OpenSourceEBike/EV_Display_Bluetooth_Ant/README.md

This project files were moved to: https://github.com/OpenSourceEBike/EBike_EScooter_modular_DIY
