OpenSourceEBike/EV_Display_Bluetooth_Ant/hardware/VESC/schematic-OLED_SPI-VESC.png

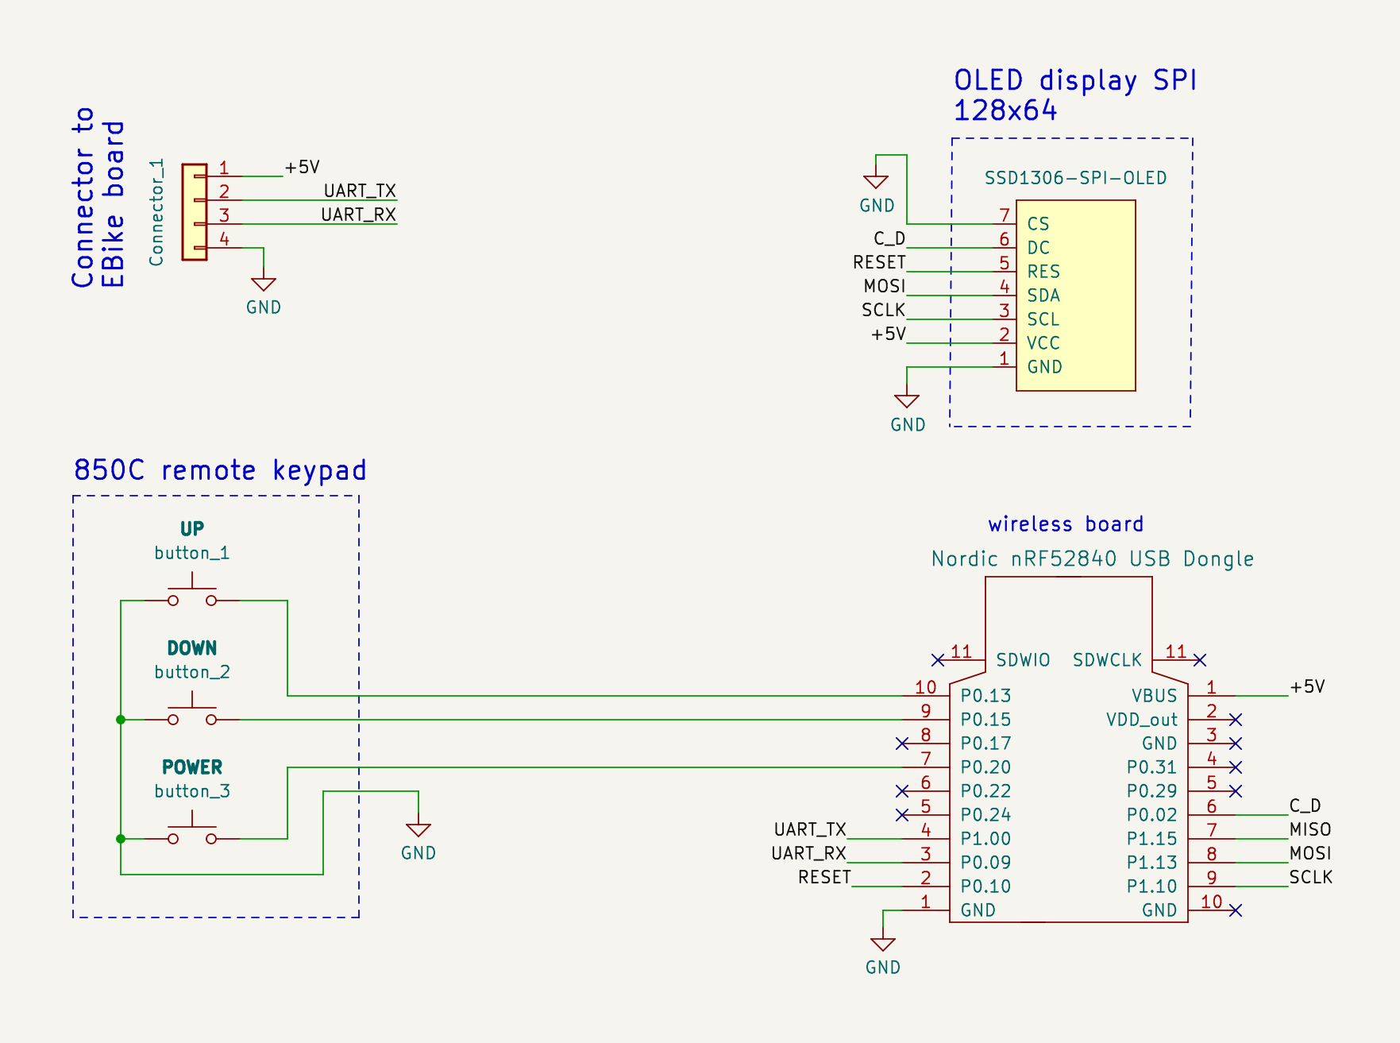
hardware/VESC/schematic-OLED_SPI-VESC.png
