OpenSourceEBike/EV_Display_Bluetooth_Ant/3D_print_enclosure/Bafang_M500_M600/assembly.FCStd

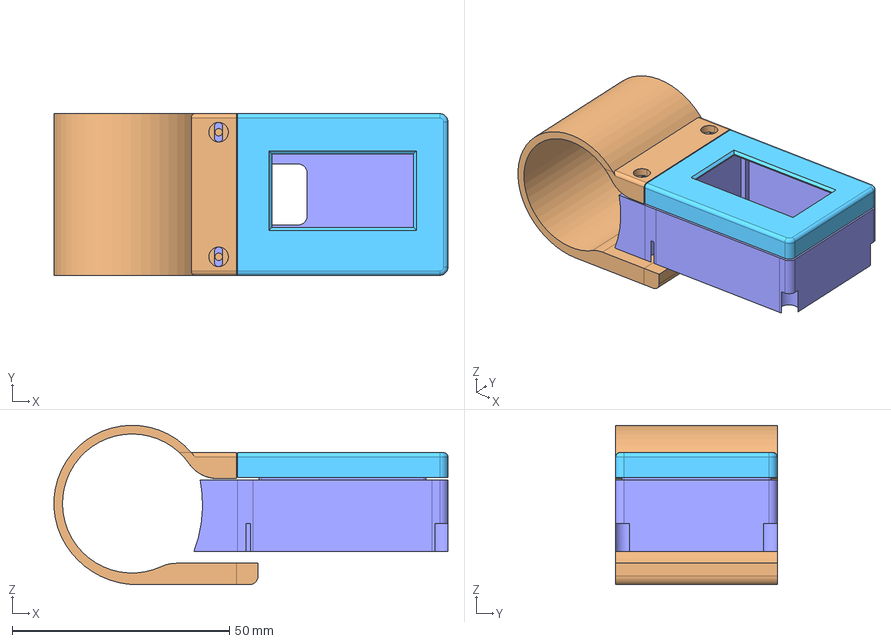
[picture p18: CAD file, 2022-11-24]
3D_print_enclosure/Bafang_M500_M600/assembly.FCStd
90.7 x 37.2 x 36.7 mm
base
cover
round
