OpenSourceEBike/EV_Display_Bluetooth_Ant/3D_print_enclosure/Bafang_M500_M600/round.FCStd

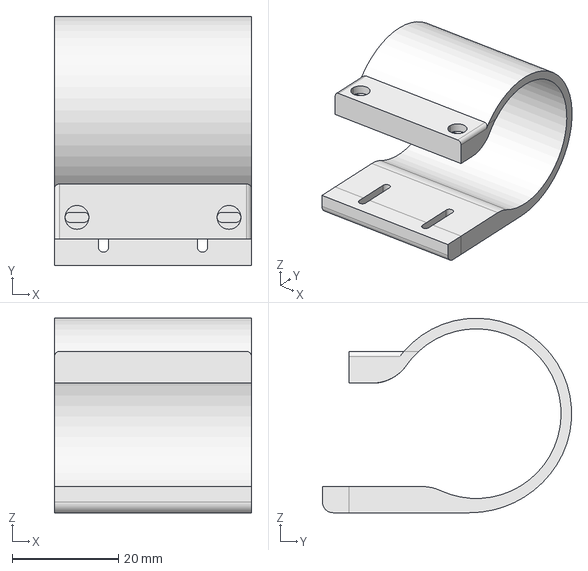
[picture p19: CAD file, 2022-11-24]
3D_print_enclosure/Bafang_M500_M600/round.FCStd
37.2 x 47.0 x 36.7 mm
