OpenSourceEBike/EV_Display_Bluetooth_Ant/3D_print_enclosure/OLED_0.96_display/display_cover.FCStd

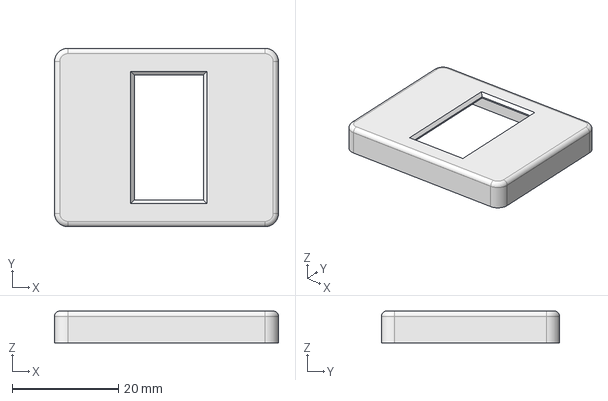
[picture p20: CAD file, 2021-11-23]
3D_print_enclosure/OLED_0.96_display/display_cover.FCStd
42.1 x 33.5 x 6.00 mm
