OpenSourceEBike/EV_Display_Bluetooth_Ant/3D_print_enclosure/OLED_1.3_display/display_base.FCStd

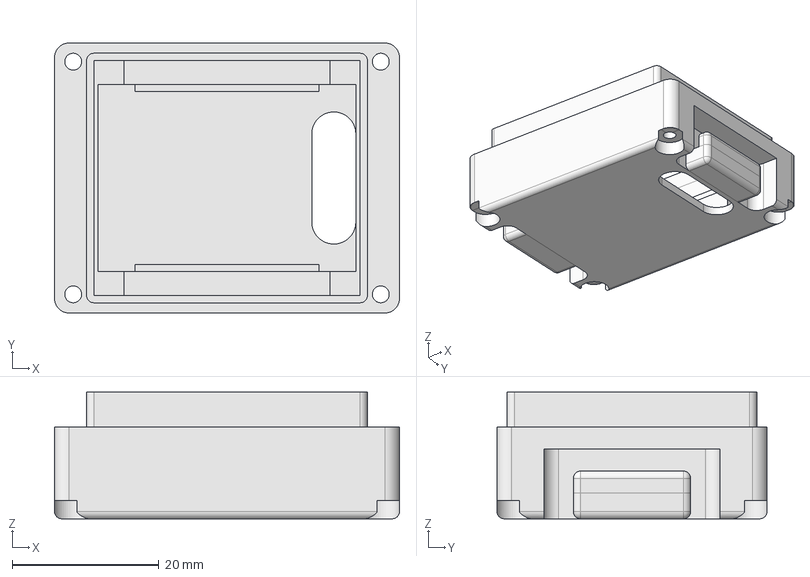
[picture p21: CAD file, 2021-11-23]
3D_print_enclosure/OLED_1.3_display/display_base.FCStd
47.0 x 36.8 x 17.3 mm
