OpenSourceEBike/EV_Display_Bluetooth_Ant/3D_print_enclosure/Bafang_M500_M600/base.FCStd

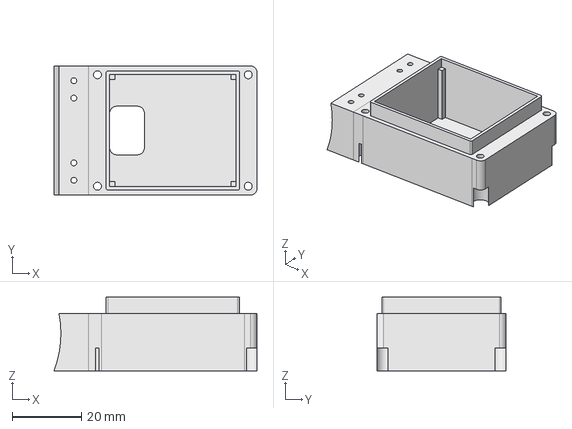
[picture p22: CAD file, 2022-11-24]
3D_print_enclosure/Bafang_M500_M600/base.FCStd
58.5 x 37.2 x 21.2 mm
