OpenSourceEBike/EV_Display_Bluetooth_Ant/3D_print_enclosure/OLED_0.96_display/display_base.FCStd

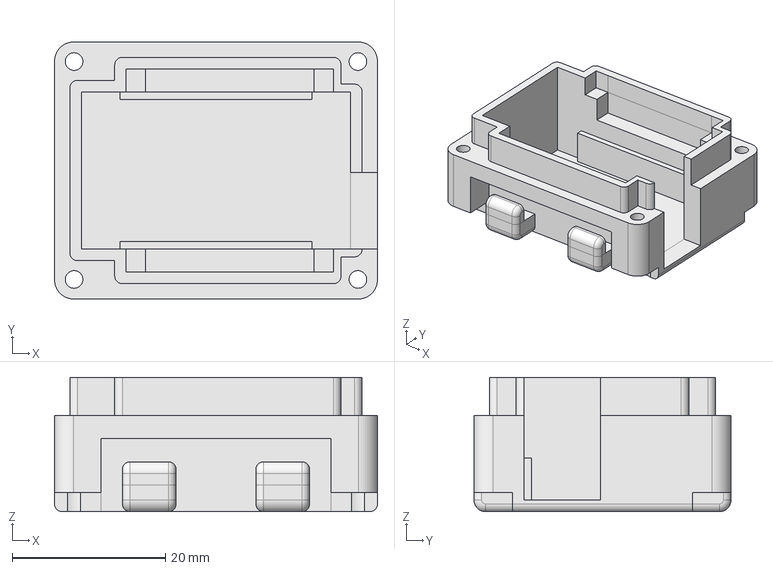
[picture p23: CAD file, 2021-11-23]
3D_print_enclosure/OLED_0.96_display/display_base.FCStd
42.1 x 33.5 x 17.5 mm
