OpenSourceEBike/EV_Display_Bluetooth_Ant/3D_print_enclosure/OLED_1.3_display/display_cover.FCStd

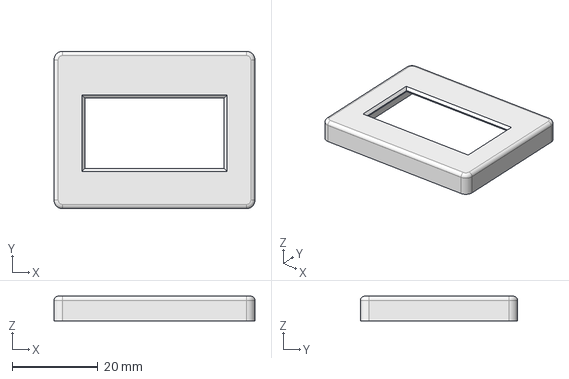
[picture p24: CAD file, 2021-11-23]
3D_print_enclosure/OLED_1.3_display/display_cover.FCStd
47.0 x 36.8 x 5.75 mm
