OpenSourceEBike/EV_Display_Bluetooth_Ant/3D_print_enclosure/Bafang_M500_M600/cover.FCStd

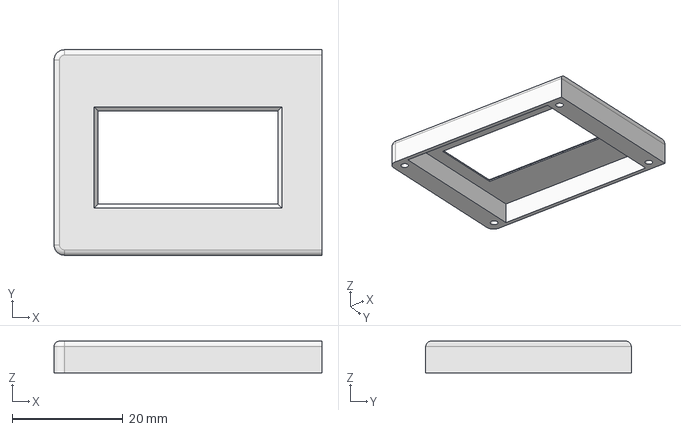
[picture p25: CAD file, 2022-11-24]
3D_print_enclosure/Bafang_M500_M600/cover.FCStd
48.5 x 37.2 x 5.75 mm
