OpenSourceEBike/EV_Display_Bluetooth_Ant/(list of files, cad)

Other CAD files:
3D_print_enclosure/OLED_0.96_display/display_base.amf
3D_print_enclosure/OLED_0.96_display/display_cover.amf
3D_print_enclosure/OLED_1.3_display/display_base.amf
3D_print_enclosure/OLED_1.3_display/display_cover.amf
