OpenSourceEBike/EV_Display_Bluetooth_Ant/hardware/TSDZ2/kicad-symbols/install_manifest.txt

/usr/local/share/kicad/library/4xxx.kicad_sym
/usr/local/share/kicad/library/4xxx_IEEE.kicad_sym
/usr/local/share/kicad/library/74xGxx.kicad_sym
/usr/local/share/kicad/library/74xx.kicad_sym
/usr/local/share/kicad/library/74xx_IEEE.kicad_sym
/usr/local/share/kicad/library/Amplifier_Audio.kicad_sym
/usr/local/share/kicad/library/Amplifier_Buffer.kicad_sym
/usr/local/share/kicad/library/Amplifier_Current.kicad_sym
/usr/local/share/kicad/library/Amplifier_Difference.kicad_sym
/usr/local/share/kicad/library/Amplifier_Instrumentation.kicad_sym
/usr/local/share/kicad/library/Amplifier_Operational.kicad_sym
/usr/local/share/kicad/library/Amplifier_Video.kicad_sym
/usr/local/share/kicad/library/Analog.kicad_sym
/usr/local/share/kicad/library/Analog_ADC.kicad_sym
/usr/local/share/kicad/library/Analog_DAC.kicad_sym
/usr/local/share/kicad/library/Analog_Switch.kicad_sym
/usr/local/share/kicad/library/Audio.kicad_sym
/usr/local/share/kicad/library/Battery_Management.kicad_sym
/usr/local/share/kicad/library/Buffer.kicad_sym
/usr/local/share/kicad/library/CPLD_Altera.kicad_sym
/usr/local/share/kicad/library/CPLD_Microchip.kicad_sym
/usr/local/share/kicad/library/CPLD_Xilinx.kicad_sym
/usr/local/share/kicad/library/CPU.kicad_sym
/usr/local/share/kicad/library/CPU_NXP_6800.kicad_sym
/usr/local/share/kicad/library/CPU_NXP_68000.kicad_sym
/usr/local/share/kicad/library/CPU_NXP_IMX.kicad_sym
/usr/local/share/kicad/library/CPU_PowerPC.kicad_sym
/usr/local/share/kicad/library/Comparator.kicad_sym
/usr/local/share/kicad/library/Connector.kicad_sym
/usr/local/share/kicad/library/Connector_Generic.kicad_sym
/usr/local/share/kicad/library/Connector_Generic_MountingPin.kicad_sym
/usr/local/share/kicad/library/Connector_Generic_Shielded.kicad_sym
/usr/local/share/kicad/library/Converter_ACDC.kicad_sym
/usr/local/share/kicad/library/Converter_DCDC.kicad_sym
/usr/local/share/kicad/library/DSP_AnalogDevices.kicad_sym
/usr/local/share/kicad/library/DSP_Freescale.kicad_sym
/usr/local/share/kicad/library/DSP_Microchip_DSPIC33.kicad_sym
/usr/local/share/kicad/library/DSP_Motorola.kicad_sym
/usr/local/share/kicad/library/DSP_Texas.kicad_sym
/usr/local/share/kicad/library/Device.kicad_sym
/usr/local/share/kicad/library/Diode.kicad_sym
/usr/local/share/kicad/library/Diode_Bridge.kicad_sym
/usr/local/share/kicad/library/Diode_Laser.kicad_sym
/usr/local/share/kicad/library/Display_Character.kicad_sym
/usr/local/share/kicad/library/Display_Graphic.kicad_sym
/usr/local/share/kicad/library/Driver_Display.kicad_sym
/usr/local/share/kicad/library/Driver_FET.kicad_sym
/usr/local/share/kicad/library/Driver_Haptic.kicad_sym
/usr/local/share/kicad/library/Driver_LED.kicad_sym
/usr/local/share/kicad/library/Driver_Motor.kicad_sym
/usr/local/share/kicad/library/Driver_Relay.kicad_sym
/usr/local/share/kicad/library/Driver_TEC.kicad_sym
/usr/local/share/kicad/library/FPGA_Lattice.kicad_sym
/usr/local/share/kicad/library/FPGA_Microsemi.kicad_sym
/usr/local/share/kicad/library/FPGA_Xilinx.kicad_sym
/usr/local/share/kicad/library/FPGA_Xilinx_Artix7.kicad_sym
/usr/local/share/kicad/library/FPGA_Xilinx_Kintex7.kicad_sym
/usr/local/share/kicad/library/FPGA_Xilinx_Spartan6.kicad_sym
/usr/local/share/kicad/library/FPGA_Xilinx_Virtex5.kicad_sym
/usr/local/share/kicad/library/FPGA_Xilinx_Virtex6.kicad_sym
/usr/local/share/kicad/library/FPGA_Xilinx_Virtex7.kicad_sym
/usr/local/share/kicad/library/Fiber_Optic.kicad_sym
/usr/local/share/kicad/library/Filter.kicad_sym
/usr/local/share/kicad/library/GPU.kicad_sym
/usr/local/share/kicad/library/Graphic.kicad_sym
/usr/local/share/kicad/library/Interface.kicad_sym
/usr/local/share/kicad/library/Interface_CAN_LIN.kicad_sym
/usr/local/share/kicad/library/Interface_CurrentLoop.kicad_sym
/usr/local/share/kicad/library/Interface_Ethernet.kicad_sym
/usr/local/share/kicad/library/Interface_Expansion.kicad_sym
/usr/local/share/kicad/library/Interface_HDMI.kicad_sym
/usr/local/share/kicad/library/Interface_HID.kicad_sym
/usr/local/share/kicad/library/Interface_LineDriver.kicad_sym
/usr/local/share/kicad/library/Interface_Optical.kicad_sym
/usr/local/share/kicad/library/Interface_Telecom.kicad_sym
/usr/local/share/kicad/library/Interface_UART.kicad_sym
/usr/local/share/kicad/library/Interface_USB.kicad_sym
/usr/local/share/kicad/library/Isolator.kicad_sym
/usr/local/share/kicad/library/Isolator_Analog.kicad_sym
/usr/local/share/kicad/library/Jumper.kicad_sym
/usr/local/share/kicad/library/LED.kicad_sym
/usr/local/share/kicad/library/Logic_LevelTranslator.kicad_sym
/usr/local/share/kicad/library/Logic_Programmable.kicad_sym
/usr/local/share/kicad/library/MCU_AnalogDevices.kicad_sym
/usr/local/share/kicad/library/MCU_Cypress.kicad_sym
/usr/local/share/kicad/library/MCU_Dialog.kicad_sym
/usr/local/share/kicad/library/MCU_Espressif.kicad_sym
/usr/local/share/kicad/library/MCU_Intel.kicad_sym
/usr/local/share/kicad/library/MCU_Microchip_8051.kicad_sym
/usr/local/share/kicad/library/MCU_Microchip_ATmega.kicad_sym
/usr/local/share/kicad/library/MCU_Microchip_ATtiny.kicad_sym
/usr/local/share/kicad/library/MCU_Microchip_AVR.kicad_sym
/usr/local/share/kicad/library/MCU_Microchip_PIC10.kicad_sym
/usr/local/share/kicad/library/MCU_Microchip_PIC12.kicad_sym
/usr/local/share/kicad/library/MCU_Microchip_PIC16.kicad_sym
/usr/local/share/kicad/library/MCU_Microchip_PIC18.kicad_sym
/usr/local/share/kicad/library/MCU_Microchip_PIC24.kicad_sym
/usr/local/share/kicad/library/MCU_Microchip_PIC32.kicad_sym
/usr/local/share/kicad/library/MCU_Microchip_SAMA.kicad_sym
/usr/local/share/kicad/library/MCU_Microchip_SAMD.kicad_sym
/usr/local/share/kicad/library/MCU_Microchip_SAME.kicad_sym
/usr/local/share/kicad/library/MCU_Microchip_SAML.kicad_sym
/usr/local/share/kicad/library/MCU_Microchip_SAMV.kicad_sym
/usr/local/share/kicad/library/MCU_Module.kicad_sym
/usr/local/share/kicad/library/MCU_NXP_ColdFire.kicad_sym
/usr/local/share/kicad/library/MCU_NXP_HC11.kicad_sym
/usr/local/share/kicad/library/MCU_NXP_HC12.kicad_sym
/usr/local/share/kicad/library/MCU_NXP_HCS12.kicad_sym
/usr/local/share/kicad/library/MCU_NXP_Kinetis.kicad_sym
/usr/local/share/kicad/library/MCU_NXP_LPC.kicad_sym
/usr/local/share/kicad/library/MCU_NXP_MAC7100.kicad_sym
/usr/local/share/kicad/library/MCU_NXP_MCore.kicad_sym
/usr/local/share/kicad/library/MCU_NXP_NTAG.kicad_sym
/usr/local/share/kicad/library/MCU_NXP_S08.kicad_sym
/usr/local/share/kicad/library/MCU_Nordic.kicad_sym
/usr/local/share/kicad/library/MCU_Parallax.kicad_sym
/usr/local/share/kicad/library/MCU_Renesas_Synergy_S1.kicad_sym
/usr/local/share/kicad/library/MCU_STC.kicad_sym
/usr/local/share/kicad/library/MCU_ST_STM32F0.kicad_sym
/usr/local/share/kicad/library/MCU_ST_STM32F1.kicad_sym
/usr/local/share/kicad/library/MCU_ST_STM32F2.kicad_sym
/usr/local/share/kicad/library/MCU_ST_STM32F3.kicad_sym
/usr/local/share/kicad/library/MCU_ST_STM32F4.kicad_sym
/usr/local/share/kicad/library/MCU_ST_STM32F7.kicad_sym
/usr/local/share/kicad/library/MCU_ST_STM32G0.kicad_sym
/usr/local/share/kicad/library/MCU_ST_STM32H7.kicad_sym
/usr/local/share/kicad/library/MCU_ST_STM32L0.kicad_sym
/usr/local/share/kicad/library/MCU_ST_STM32L1.kicad_sym
/usr/local/share/kicad/library/MCU_ST_STM32L4+.kicad_sym
/usr/local/share/kicad/library/MCU_ST_STM32L4.kicad_sym
/usr/local/share/kicad/library/MCU_ST_STM8.kicad_sym
/usr/local/share/kicad/library/MCU_SiFive.kicad_sym
/usr/local/share/kicad/library/MCU_SiliconLabs.kicad_sym
/usr/local/share/kicad/library/MCU_Texas.kicad_sym
/usr/local/share/kicad/library/MCU_Texas_MSP430.kicad_sym
/usr/local/share/kicad/library/MCU_Texas_SimpleLink.kicad_sym
/usr/local/share/kicad/library/Mechanical.kicad_sym
/usr/local/share/kicad/library/Memory_EEPROM.kicad_sym
/usr/local/share/kicad/library/Memory_EPROM.kicad_sym
/usr/local/share/kicad/library/Memory_Flash.kicad_sym
/usr/local/share/kicad/library/Memory_NVRAM.kicad_sym
/usr/local/share/kicad/library/Memory_RAM.kicad_sym
/usr/local/share/kicad/library/Memory_ROM.kicad_sym
/usr/local/share/kicad/library/Memory_UniqueID.kicad_sym
/usr/local/share/kicad/library/Motor.kicad_sym
/usr/local/share/kicad/library/Oscillator.kicad_sym
/usr/local/share/kicad/library/Potentiometer_Digital.kicad_sym
/usr/local/share/kicad/library/Power_Management.kicad_sym
/usr/local/share/kicad/library/Power_Protection.kicad_sym
/usr/local/share/kicad/library/Power_Supervisor.kicad_sym
/usr/local/share/kicad/library/RF.kicad_sym
/usr/local/share/kicad/library/RF_AM_FM.kicad_sym
/usr/local/share/kicad/library/RF_Amplifier.kicad_sym
/usr/local/share/kicad/library/RF_Bluetooth.kicad_sym
/usr/local/share/kicad/library/RF_Filter.kicad_sym
/usr/local/share/kicad/library/RF_GPS.kicad_sym
/usr/local/share/kicad/library/RF_GSM.kicad_sym
/usr/local/share/kicad/library/RF_Mixer.kicad_sym
/usr/local/share/kicad/library/RF_Module.kicad_sym
/usr/local/share/kicad/library/RF_NFC.kicad_sym
/usr/local/share/kicad/library/RF_RFID.kicad_sym
/usr/local/share/kicad/library/RF_Switch.kicad_sym
/usr/local/share/kicad/library/RF_WiFi.kicad_sym
/usr/local/share/kicad/library/RF_ZigBee.kicad_sym
/usr/local/share/kicad/library/Reference_Current.kicad_sym
/usr/local/share/kicad/library/Reference_Voltage.kicad_sym
/usr/local/share/kicad/library/Regulator_Controller.kicad_sym
/usr/local/share/kicad/library/Regulator_Current.kicad_sym
/usr/local/share/kicad/library/Regulator_Linear.kicad_sym
/usr/local/share/kicad/library/Regulator_SwitchedCapacitor.kicad_sym
/usr/local/share/kicad/library/Regulator_Switching.kicad_sym
/usr/local/share/kicad/library/Relay.kicad_sym
/usr/local/share/kicad/library/Relay_SolidState.kicad_sym
/usr/local/share/kicad/library/Security.kicad_sym
/usr/local/share/kicad/library/Sensor.kicad_sym
/usr/local/share/kicad/library/Sensor_Audio.kicad_sym
/usr/local/share/kicad/library/Sensor_Current.kicad_sym
/usr/local/share/kicad/library/Sensor_Distance.kicad_sym
/usr/local/share/kicad/library/Sensor_Gas.kicad_sym
/usr/local/share/kicad/library/Sensor_Humidity.kicad_sym
/usr/local/share/kicad/library/Sensor_Magnetic.kicad_sym
/usr/local/share/kicad/library/Sensor_Motion.kicad_sym
/usr/local/share/kicad/library/Sensor_Optical.kicad_sym
/usr/local/share/kicad/library/Sensor_Pressure.kicad_sym
/usr/local/share/kicad/library/Sensor_Proximity.kicad_sym
/usr/local/share/kicad/library/Sensor_Temperature.kicad_sym
/usr/local/share/kicad/library/Sensor_Touch.kicad_sym
/usr/local/share/kicad/library/Sensor_Voltage.kicad_sym
/usr/local/share/kicad/library/Simulation_SPICE.kicad_sym
/usr/local/share/kicad/library/Switch.kicad_sym
/usr/local/share/kicad/library/Timer.kicad_sym
/usr/local/share/kicad/library/Timer_PLL.kicad_sym
/usr/local/share/kicad/library/Timer_RTC.kicad_sym
/usr/local/share/kicad/library/Transformer.kicad_sym
/usr/local/share/kicad/library/Transistor_Array.kicad_sym
/usr/local/share/kicad/library/Transistor_BJT.kicad_sym
/usr/local/share/kicad/library/Transistor_FET.kicad_sym
/usr/local/share/kicad/library/Transistor_IGBT.kicad_sym
/usr/local/share/kicad/library/Triac_Thyristor.kicad_sym
/usr/local/share/kicad/library/Valve.kicad_sym
/usr/local/share/kicad/library/Video.kicad_sym
/usr/local/share/kicad/library/power.kicad_sym
/usr/local/share/kicad/library/pspice.kicad_sym
/usr/local/share/kicad/template/sym-lib-table
