OpenSourceEBike/EV_Display_Bluetooth_Ant/hardware/Bafang_M500_M600/schematic-OLED_SPI-Bafang_M500_M600.kicad_sch

## KiCad design hardware/Bafang_M500_M600/schematic-OLED_SPI-Bafang_M500_M600.kicad_sch (2022-05-09)

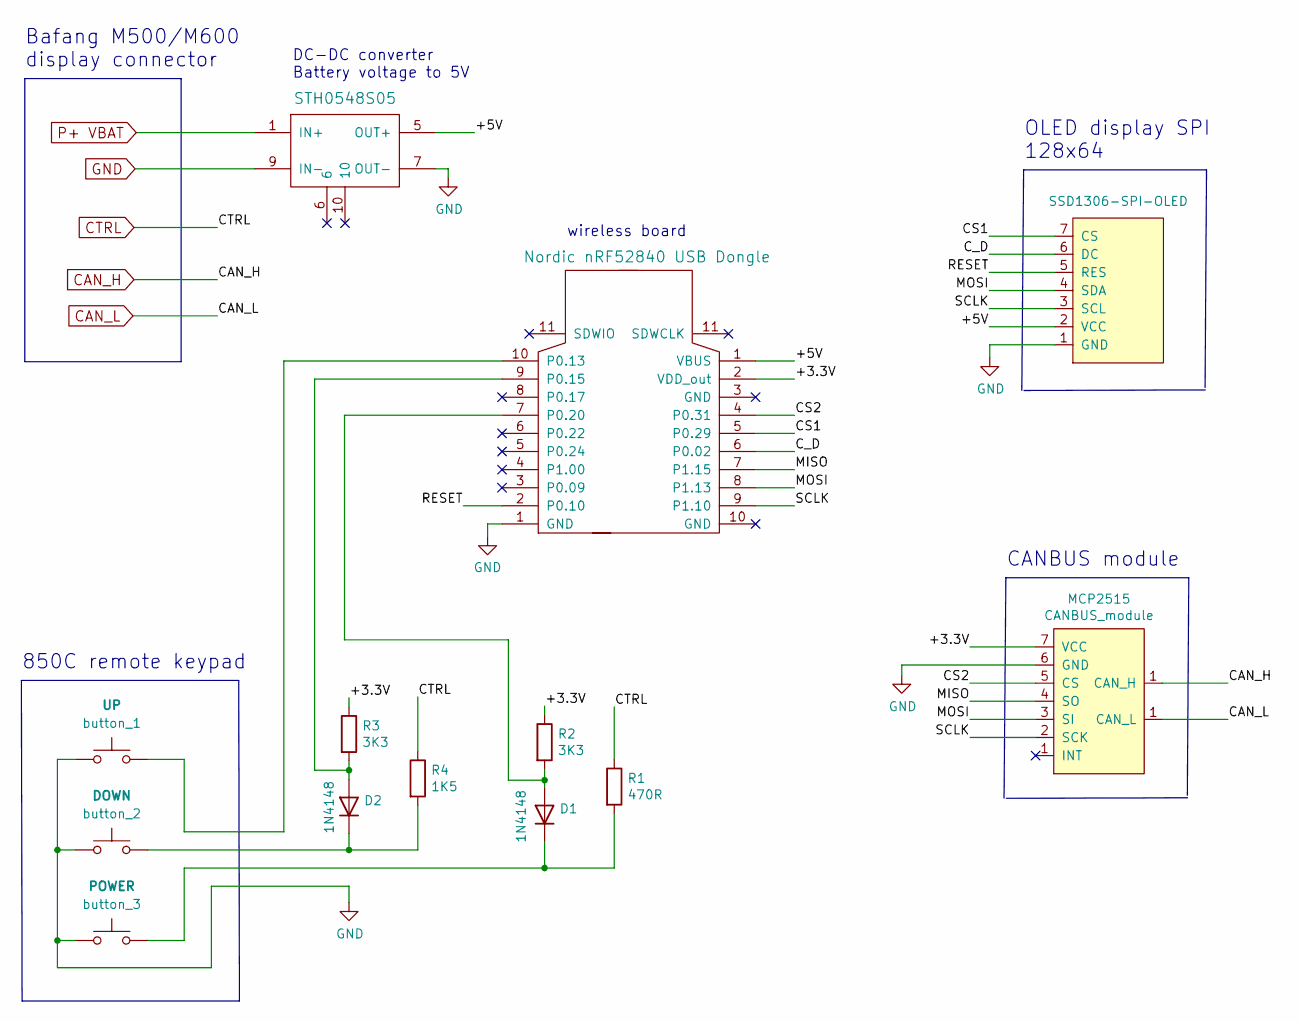
[picture p26: schematic schematic-OLED_SPI-Bafang_M500_M600.kicad_sch]

Parts:
D1, D2: 1N4148; D_DO-35_SOD27_P7.62mm_Horizontal
MCP2515: CANBUS_module
NA1: SSD1306-SPI-OLED
R1: 470R
R2, R3: 3K3
R4: 1K5
U1: STH0548S05
U2: Nordic nRF52840 USB Dongle
button_1: UP
button_2: DOWN
button_3: POWER

Connections:
+3.3V: MCP2515.7 (VCC), R2.1, R3.1, U2.2 (P0.10)
+5V: NA1.2 (VCC), U1.5 (OUT+), U2.1 (GND)
CAN_H: MCP2515.1 (CAN_H)
CAN_L: MCP2515.1 (CAN_H)
CS1: NA1.7 (CS), U2.5 (P0.24)
CS2: MCP2515.5 (CS), U2.4 (P0.31)
CTRL: R1.1, R4.1
C_D: NA1.6 (DC), U2.6 (P0.02)
GND: MCP2515.6 (GND), NA1.1 (GND), U1.7 (OUT-), U1.9 (IN-), U2.1 (GND), button_1.1, button_2.1, button_3.1
MISO: MCP2515.4 (SO), U2.7 (P0.20)
MOSI: MCP2515.3 (SI), NA1.4 (SDA), U2.8 (P0.17)
unnamed: D1.1 (K), R1.2, button_3.2
unnamed: D1.2 (A), R2.2, U2.7 (P0.20)
unnamed: D2.1 (K), R4.2, button_2.2
unnamed: D2.2 (A), R3.2, U2.9 (P0.15)
unnamed: U2.10 (GND), button_1.2
P+ VBAT: U1.1 (IN+)
RESET: NA1.5 (RES), U2.2 (P0.10)
SCLK: MCP2515.2 (SCK), NA1.3 (SCL), U2.9 (P0.15)

Notes on the sheet:
Bafang M500/M600 display connector
CANBUS module
wireless board
850C remote keypad
OLED display SPI 128x64
DC-DC converter Battery voltage to 5V
