OpenSourceEBike/EV_Display_Bluetooth_Ant/hardware/TSDZ2/schematic-OLED_SPI.sch

## KiCad design hardware/TSDZ2/schematic-OLED_SPI.sch (2022-03-30)

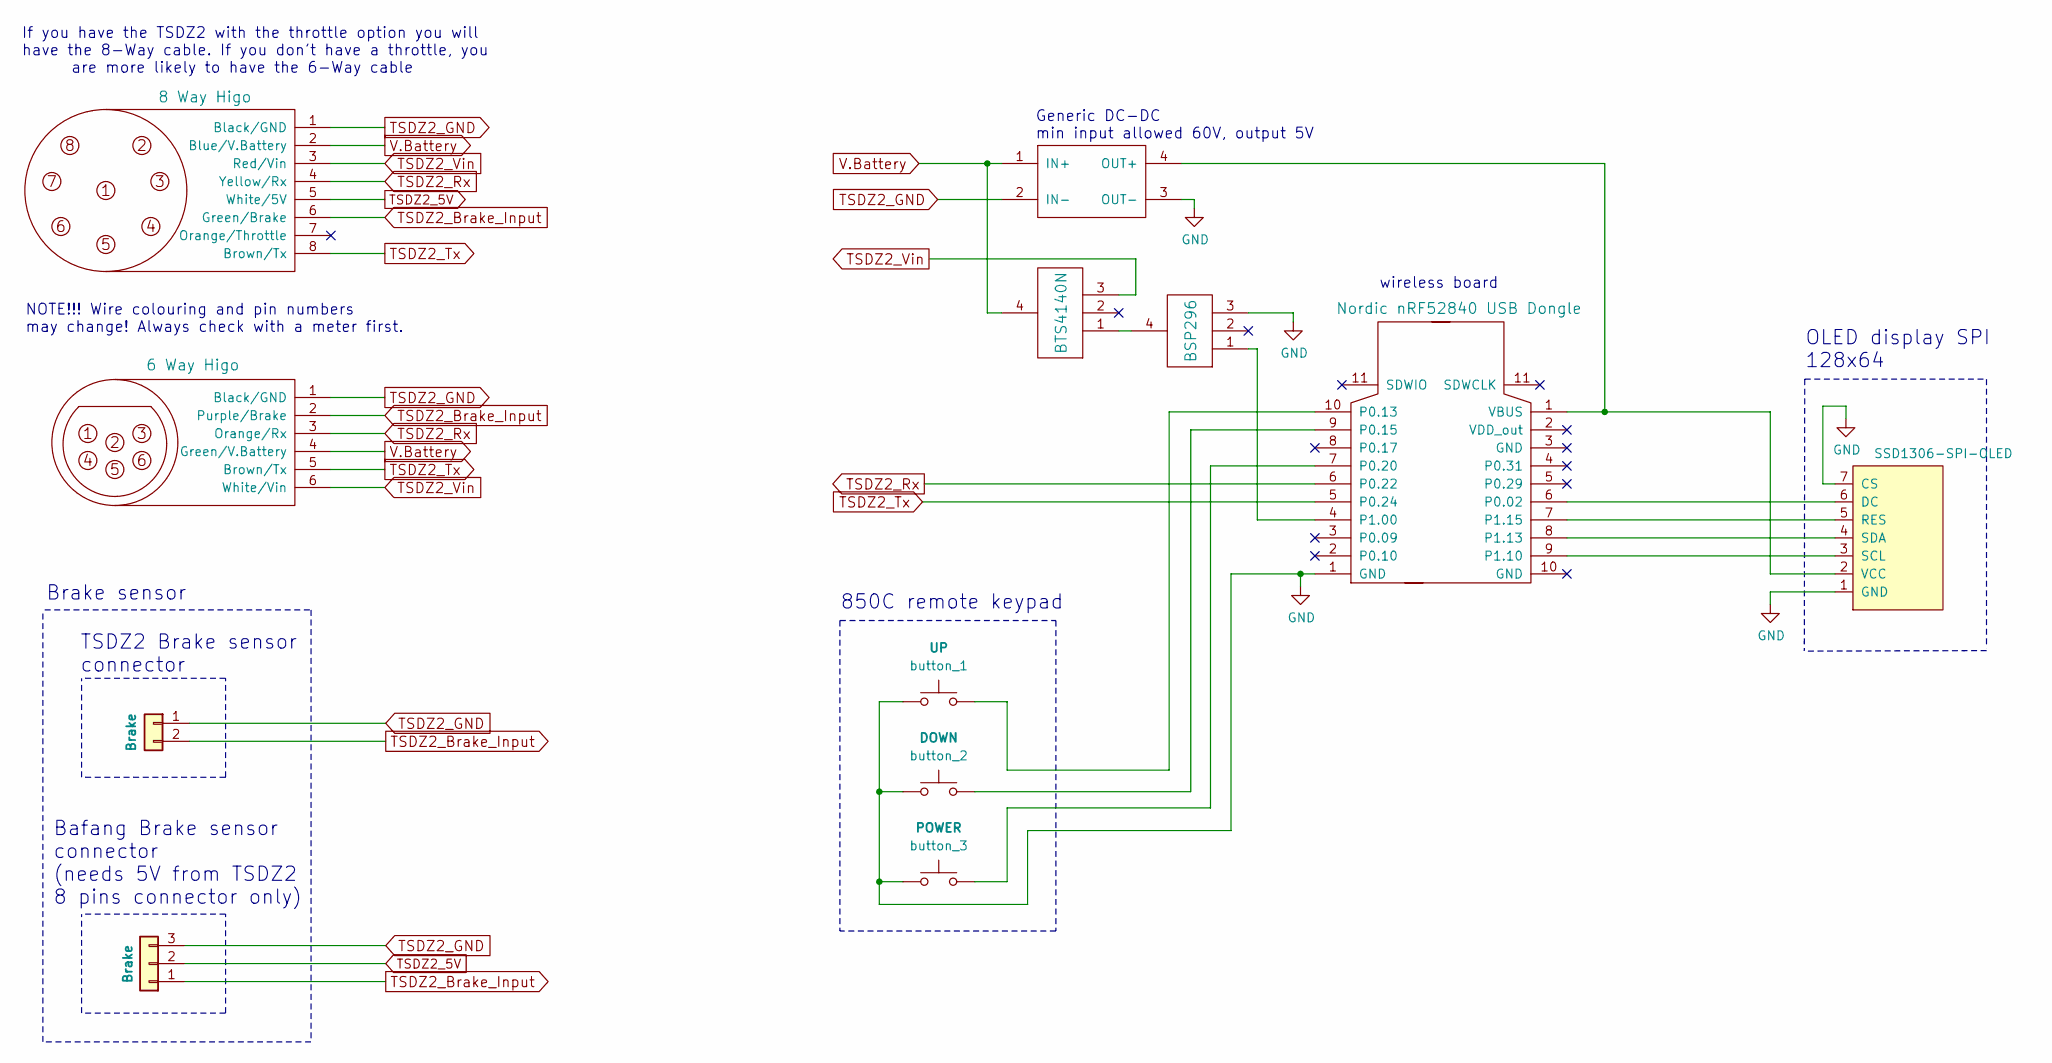
[picture p28: schematic schematic-OLED_SPI.sch]

Parts:
Brake: Brake
NA: SSD1306-SPI-OLED
button_1: UP
button_2: DOWN
button_3: POWER

Connections:
GND: NA.1 (GND), NA.7 (CS), button_1.1, button_2.1, button_3.1
TSDZ2_5V: Brake.2
TSDZ2_Brake_Input: Brake.1
TSDZ2_GND: Brake.3

Notes on the sheet:
NOTE!!! Wire colouring and pin numbers may change! Always check with a meter first.
If you have the TSDZ2 with the throttle option you will have the 8-Way cable. If you don't have a throttle, you are more likely to have the 6-Way cable
wireless board
Generic DC-DC min input allowed 60V, output 5V
850C remote keypad
TSDZ2 Brake sensor connector
Bafang Brake sensor connector (needs 5V from TSDZ2 8 pins connector only)
OLED display SPI 128x64
Brake sensor
