OpenSourceEBike/EV_Display_Bluetooth_Ant/hardware/VESC/schematic-OLED_SPI-VESC.kicad_sch

## KiCad design hardware/VESC/schematic-OLED_SPI-VESC.kicad_sch (2022-11-24)

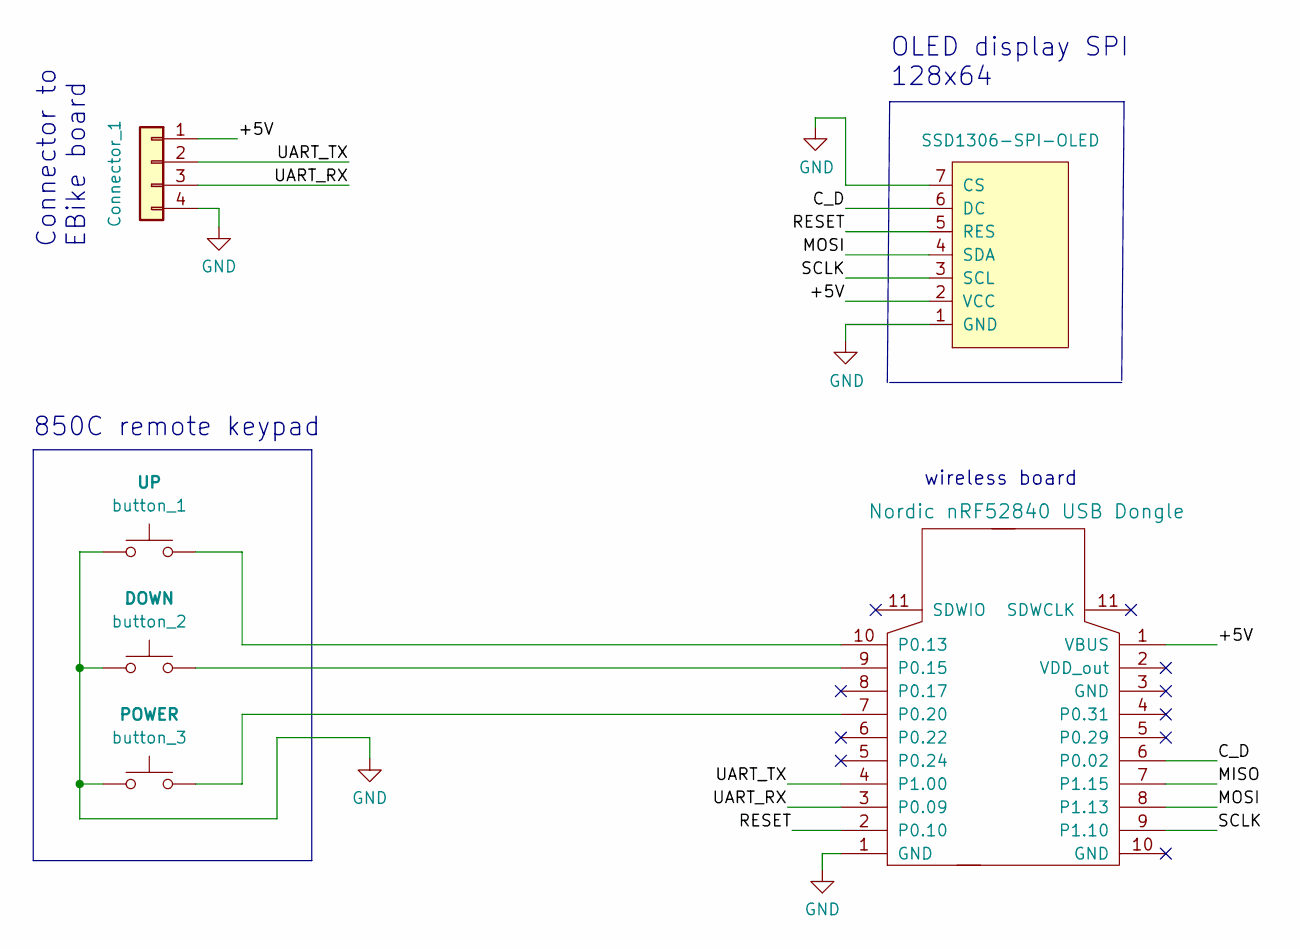
[picture p29: schematic schematic-OLED_SPI-VESC.kicad_sch]

Parts:
NA1: SSD1306-SPI-OLED
U2: Nordic nRF52840 USB Dongle
button_1: UP
button_2: DOWN
button_3: POWER

Connections:
+5V: NA1.2 (VCC), U2.1 (GND)
C_D: NA1.6 (DC), U2.6 (P0.02)
GND: NA1.1 (GND), U2.1 (GND)
MISO: U2.7 (P0.20)
MOSI: NA1.4 (SDA), U2.8 (P0.17)
unnamed: U2.7 (P0.20), button_3.2
unnamed: U2.9 (P0.15), button_2.2
unnamed: U2.10 (GND), button_1.2
unnamed: button_1.1, button_2.1, button_3.1
RESET: NA1.5 (RES), U2.2 (P0.10)
SCLK: NA1.3 (SCL), U2.9 (P0.15)
UART_RX: U2.3 (GND)
UART_TX: U2.4 (P0.31)

Notes on the sheet:
Connector to EBike board
wireless board
850C remote keypad
OLED display SPI 128x64
