OpenSourceEBike/EV_Display_Bluetooth_Ant/firmware/display/main.c

/*
 * TSDZ2 EBike wireless firmware
 *
 * Copyright (C) Casainho, 2020
 *
 * Released under the GPL License, Version 3
 *
 */

#include <stdio.h>
#include "nrf_log.h"
#include "nrf_log_ctrl.h"
#include "nrf_log_default_backends.h"
#include "nrf_drv_clock.h"
#include "nrf.h"
#include "hardfault.h"
#include "app_error.h"
#include "app_timer.h"
#include "nrf_pwr_mgmt.h"
#include "nrf_sdh.h"
#include "ble.h"
#include "ble_err.h"
#include "ble_hci.h"
#include "ble_srv_common.h"
#include "ble_advdata.h"
#include "ble_conn_params.h"
#include "ble_conn_state.h"
#include "peer_manager.h"
#include "peer_manager_handler.h"
#include "ble_advdata.h"
#include "ble_advertising.h"
#include "nrf_sdh.h"
#include "nrf_sdh_ble.h"
#include "nrf_ble_gatt.h"
#include "nrf_ble_qwr.h"
#include "ble_services.h"
#include "nrf_sdh_ant.h"
#include "ant_key_manager.h"
#include "antplus_lev.h"
#include "antplus_controls.h"
#include "pins.h"
#include "uart.h"
#include "nrf_drv_uart.h"
#include "app_util_platform.h"
#include "app_uart.h"
#include "eeprom.h"
#include "state.h"
#include "ant_interface.h"
#include "ant_search_config.h"
#include "nrf_delay.h"
#include "fds.h"
#include "nrf_power.h"
#include <stdbool.h>
#include "boards.h"
#include "nrf_bootloader_info.h"
#include "buttons.h"
#include "ledalert.h"
#include "common.h"
#include "display.h"
#include "ugui.h"
#include "screen.h"
#include "mainscreen.h"
#include "configscreen.h"
#include "utils.h"
#include "spi.h"
#include "CANSPI.h"
#include "can.h"

UG_GUI gui;

extern uint8_t ui8_g_battery_soc;
static rt_vars_t *mp_rt_vars;
static ui_vars_t *mp_ui_vars;

volatile uint8_t ui8_m_enter_bootloader = 0;
volatile uint8_t ui8_m_ant_device_id = 0;
volatile uint8_t ui8_m_flash_configurations = 0;

static uint8_t ui8_walk_assist_timeout = 0;
static uint8_t ui8_walk_assist_state_process_locally = 0;
uint8_t ui8_braking_led_state = 0;

typedef enum
{
  MOTOR_STATE_OFF_START,
  MOTOR_STATE_OFF_WAIT,
  MOTOR_STATE_OFF,
  MOTOR_STATE_ON_START,
  MOTOR_STATE_ON,
} motor_power_state_t;

motor_power_state_t m_motor_state = MOTOR_STATE_ON_START;

#define MSEC_PER_TICK 10
APP_TIMER_DEF(main_timer);
#define MAIN_INTERVAL APP_TIMER_TICKS(MSEC_PER_TICK)
volatile uint32_t main_ticks;
uint32_t ui32_seconds_since_startup = 0;

bool m_rt_processing_stop = false;

void rt_processing_stop(void)
{
  m_rt_processing_stop = true;
}

void rt_processing_start(void)
{
  m_rt_processing_stop = false;
}

#define LEV_HW_REVISION 1
#define LEV_MANUFACTURER_ID (UINT16_MAX - 1)
#define LEV_MODEL_NUMBER 1
#define LEV_SW_REVISION_MAJOR 1
#define LEV_SW_REVISION_MINOR 1
#define LEV_SERIAL_NUMBER 1234567
#define LEV_CHANNEL_NUM 0    // ?? seems can be any value from 0 to 8
#define CHAN_ID_TRANS_TYPE 5 // LEV table 4.2
#define CHAN_ID_DEV_NUM 1    // [1 - 65535], LEV table 4.2
#define ANTPLUS_NETWORK_NUM 0
#define ANT_LEV_ANT_OBSERVER_PRIO 1

#define CONTROLS_HW_REVISION 2
#define CONTROLS_MANUFACTURER_ID 255
#define CONTROLS_MODEL_NUMBER 2
#define CONTROLS_SW_REVISION_MAJOR 2
#define CONTROLS_SW_REVISION_MINOR 2
#define CONTROLS_SERIAL_NUMBER 3241
#define CONTROLS_CHANNEL_NUM 1 //see: NRF_SDH_ANT_TOTAL_CHANNELS_ALLOCATED in sdk_config.sys
#define ANT_CONTROLS_ANT_OBSERVER_PRIO 1
#define CONTROLS_CHAN_ID_TRANS_TYPE 0 // slave wildcard match
#define CONTROLS_CHAN_ID_DEV_NUM 0 // wildcard match to any master

void antplus_lev_evt_handler_pre(antplus_lev_profile_t *p_profile, antplus_lev_evt_t event);
void antplus_lev_evt_handler_post(antplus_lev_profile_t *p_profile, antplus_lev_evt_t event);
void antplus_controls_evt_handler(antplus_controls_profile_t *p_profile, antplus_controls_evt_t event);

static antplus_lev_profile_t m_antplus_lev;
antplus_controls_profile_t m_antplus_controls;

LEV_SENS_CHANNEL_CONFIG_DEF(m_antplus_lev,
                            LEV_CHANNEL_NUM,
                            CHAN_ID_TRANS_TYPE,
                            CHAN_ID_DEV_NUM,
                            ANTPLUS_NETWORK_NUM);
LEV_SENS_PROFILE_CONFIG_DEF(m_antplus_lev,
                            antplus_lev_evt_handler_pre,
                            antplus_lev_evt_handler_post);

CONTROLS_SENS_CHANNEL_CONFIG_DEF(m_antplus_controls,
                                 CONTROLS_CHANNEL_NUM,
                                 CONTROLS_CHAN_ID_TRANS_TYPE,
                                 CONTROLS_CHAN_ID_DEV_NUM,
                                 ANTPLUS_NETWORK_NUM,
                                 CONTROLS_MSG_PERIOD_4Hz);

CONTROLS_SENS_PROFILE_CONFIG_DEF(m_antplus_controls,
                                 antplus_controls_evt_handler);                            

NRF_SDH_ANT_OBSERVER(m_ant_observer, ANT_LEV_ANT_OBSERVER_PRIO, antplus_lev_sens_evt_handler, &m_antplus_lev);
NRF_SDH_ANT_OBSERVER(m_ant_observer_control, ANT_CONTROLS_ANT_OBSERVER_PRIO, antplus_controls_sens_evt_handler, &m_antplus_controls);

#define DEVICE_NAME "Display" /**< Name of device. Will be included in the advertising data. */

#define APP_BLE_CONN_CFG_TAG 1 /**< A tag identifying the SoftDevice BLE configuration. */

#define APP_ADV_INTERVAL 64                                    /**< The advertising interval (in units of 0.625 ms; this value corresponds to 40 ms). */
#define APP_ADV_DURATION BLE_GAP_ADV_TIMEOUT_GENERAL_UNLIMITED /**< The advertising time-out (in units of seconds). When set to 0, we will never time out. */

#define MIN_CONN_INTERVAL MSEC_TO_UNITS(100, UNIT_1_25_MS) /**< Minimum acceptable connection interval (0.5 seconds). */
#define MAX_CONN_INTERVAL MSEC_TO_UNITS(200, UNIT_1_25_MS) /**< Maximum acceptable connection interval (1 second). */
#define SLAVE_LATENCY 0                                    /**< Slave latency. */
#define CONN_SUP_TIMEOUT MSEC_TO_UNITS(4000, UNIT_10_MS)   /**< Connection supervisory time-out (4 seconds). */

#define FIRST_CONN_PARAMS_UPDATE_DELAY APP_TIMER_TICKS(20000) /**< Time from initiating event (connect or start of notification) to first time sd_ble_gap_conn_param_update is called (15 seconds). */
#define NEXT_CONN_PARAMS_UPDATE_DELAY APP_TIMER_TICKS(5000)   /**< Time between each call to sd_ble_gap_conn_param_update after the first call (5 seconds). */
#define MAX_CONN_PARAMS_UPDATE_COUNT 3                        /**< Number of attempts before giving up the connection parameter negotiation. */

#define SEC_PARAM_BOND 1                               /**< Perform bonding. */
#define SEC_PARAM_MITM 0                               /**< Man In The Middle protection not required. */
#define SEC_PARAM_LESC 0                               /**< LE Secure Connections not enabled. */
#define SEC_PARAM_KEYPRESS 0                           /**< Keypress notifications not enabled. */
#define SEC_PARAM_IO_CAPABILITIES BLE_GAP_IO_CAPS_NONE /**< No I/O capabilities. */
#define SEC_PARAM_OOB 0                                /**< Out Of Band data not available. */
#define SEC_PARAM_MIN_KEY_SIZE 7                       /**< Minimum encryption key size. */
#define SEC_PARAM_MAX_KEY_SIZE 16                      /**< Maximum encryption key size. */

#define APP_FEATURE_NOT_SUPPORTED BLE_GATT_STATUS_ATTERR_APP_BEGIN + 2 /**< Reply when unsupported features are requested. */

NRF_BLE_GATT_DEF(m_gatt);           /**< GATT module instance. */
NRF_BLE_QWR_DEF(m_qwr);             /**< Context for the Queued Write module.*/
BLE_ADVERTISING_DEF(m_advertising); /**< Advertising module instance. */
BLE_ANT_ID_DEF(m_ble_ant_id_service);

void enter_dfu(void);

static uint16_t m_conn_handle = BLE_CONN_HANDLE_INVALID; /**< Handle of the current connection. */

/**< Universally unique service identifiers. */
static ble_uuid_t m_adv_uuids[] = 
{
  {ANT_ID_UUID_SERVICE, BLE_UUID_TYPE_VENDOR_BEGIN},
};

/**@brief Clear bond information from persistent storage.
 */
static void delete_bonds(void)
{
  ret_code_t err_code;

  NRF_LOG_INFO("Erase bonds!");

  err_code = pm_peers_delete();
  APP_ERROR_CHECK(err_code);
}

/**@brief Function for starting advertising.
 */
static void advertising_start(bool erase_bonds)
{
  if (erase_bonds == true)
  {
    delete_bonds();
    // Advertising is started by PM_EVT_PEERS_DELETE_SUCCEEDED event.
  }
  else
  {
    uint32_t err_code = ble_advertising_start(&m_advertising, BLE_ADV_MODE_FAST);
    APP_ERROR_CHECK(err_code);
  }
}

/**@brief Function for handling BLE events.
 *
 * @param[in]   p_ble_evt   Bluetooth stack event.
 * @param[in]   p_context   Unused.
 */
static void ble_evt_handler(ble_evt_t const *p_ble_evt, void *p_context)
{
  ret_code_t err_code;

  switch (p_ble_evt->header.evt_id)
  {
  case BLE_GAP_EVT_CONNECTED:
    NRF_LOG_INFO("Connected");
    m_conn_handle = p_ble_evt->evt.gap_evt.conn_handle;
    err_code = nrf_ble_qwr_conn_handle_assign(&m_qwr, m_conn_handle);
    APP_ERROR_CHECK(err_code);
    break;

  case BLE_GAP_EVT_DISCONNECTED:
    NRF_LOG_INFO("Disconnected");
    m_conn_handle = BLE_CONN_HANDLE_INVALID;
    advertising_start(false);
    break;

  case BLE_GAP_EVT_SEC_PARAMS_REQUEST:
    break;

  case BLE_GAP_EVT_PHY_UPDATE_REQUEST:
  {
    NRF_LOG_DEBUG("PHY update request.");
    ble_gap_phys_t const phys =
        {
            .rx_phys = BLE_GAP_PHY_AUTO,
            .tx_phys = BLE_GAP_PHY_AUTO,
        };
    err_code = sd_ble_gap_phy_update(p_ble_evt->evt.gap_evt.conn_handle, &phys);
    APP_ERROR_CHECK(err_code);
  }
  break;

  case BLE_GATTS_EVT_SYS_ATTR_MISSING:
    // No system attributes have been stored.
    err_code = sd_ble_gatts_sys_attr_set(m_conn_handle, NULL, 0, 0);
    APP_ERROR_CHECK(err_code);
    break;

  case BLE_GATTC_EVT_TIMEOUT:
    // Disconnect on GATT Client timeout event.
    NRF_LOG_DEBUG("GATT Client Timeout.");
    err_code = sd_ble_gap_disconnect(p_ble_evt->evt.gattc_evt.conn_handle,
                                     BLE_HCI_REMOTE_USER_TERMINATED_CONNECTION);
    APP_ERROR_CHECK(err_code);
    break;

  case BLE_GATTS_EVT_TIMEOUT:
    // Disconnect on GATT Server timeout event.
    NRF_LOG_DEBUG("GATT Server Timeout.");
    err_code = sd_ble_gap_disconnect(p_ble_evt->evt.gatts_evt.conn_handle,
                                     BLE_HCI_REMOTE_USER_TERMINATED_CONNECTION);
    APP_ERROR_CHECK(err_code);
    break;

  case BLE_GATTS_EVT_RW_AUTHORIZE_REQUEST:
  {
    ble_gatts_evt_rw_authorize_request_t req;
    ble_gatts_rw_authorize_reply_params_t auth_reply;

    req = p_ble_evt->evt.gatts_evt.params.authorize_request;

    if (req.type != BLE_GATTS_AUTHORIZE_TYPE_INVALID)
    {
      if ((req.request.write.op == BLE_GATTS_OP_PREP_WRITE_REQ) ||
          (req.request.write.op == BLE_GATTS_OP_EXEC_WRITE_REQ_NOW) ||
          (req.request.write.op == BLE_GATTS_OP_EXEC_WRITE_REQ_CANCEL))
      {
        if (req.type == BLE_GATTS_AUTHORIZE_TYPE_WRITE)
        {
          auth_reply.type = BLE_GATTS_AUTHORIZE_TYPE_WRITE;
        }
        else
        {
          auth_reply.type = BLE_GATTS_AUTHORIZE_TYPE_READ;
        }
        auth_reply.params.write.gatt_status = APP_FEATURE_NOT_SUPPORTED;
        sd_ble_gatts_rw_authorize_reply(p_ble_evt->evt.gatts_evt.conn_handle, &auth_reply);
      }
    }
  }
  break; // BLE_GATTS_EVT_RW_AUTHORIZE_REQUEST

  default:
    // No implementation needed.
    break;
  }
}

void antplus_lev_evt_handler_pre(antplus_lev_profile_t *p_profile, antplus_lev_evt_t event)
{
  nrf_pwr_mgmt_feed();

  // set variables for ANT transmission in order of connectIQ fields
  //  1. lev speed
  p_profile->common.lev_speed = ui_vars.ui16_wheel_speed_x10;

  // 2.  assist level
  uint8_t temp = mp_ui_vars->ui8_assist_level;
  // limit assist level value to max ANT+ LEV supports
  if (temp > 7)
  {
    temp = 7;
  }
  p_profile->common.travel_mode_state = (temp << 3) & 0x38;
  p_profile->page_16.travel_mode = p_profile->common.travel_mode_state;

  // 3. lights
  // set by the remote control page 16 command
  // p_profile->common.system_state = p_profile->common.system_state && 0xf0; //lights off
  p_profile->common.system_state = 0x00; // lights off
  p_profile->common.system_state |= (mp_ui_vars->ui8_lights << 3);

  // 4. state of charge
  p_profile->page_3.battery_soc = ui8_g_battery_soc;

  // 5. battery voltage
  // battery voltage for ANT_LEV is 0.25V/bit
  p_profile->page_4.battery_voltage = (ui_vars.ui16_battery_voltage_filtered_x10) / 2.5;

  // 6. odometer
  // 3 bytes -0.01km/bit max value 167772.15km
  // p_profile->common.odometer = ui_vars.ui32_odometer_x10 / 100;
  p_profile->common.odometer = 0; // not yet implemented

  // 7. remaining range
  // 1 km/bit, max value 4095km
  //  p_profile->page_2.remaining_range = ui_vars.battery_energy_km_value_x100 / 100;
  p_profile->page_2.remaining_range = 0; // not yet implemented

  // 8. motor temperature
  // one byte, bits 4-6
  // 000 unknown
  // 001  cold
  // 010 cold/warm
  // 011 warm
  // 100 warm/hot
  // 101 hot
  temp = ui_vars.ui8_motor_temperature;
  uint8_t temp_max = ui_vars.ui8_motor_temperature_max_value_to_limit;
  uint8_t temp_min = ui_vars.ui8_motor_temperature_min_value_to_limit;
  uint8_t lev_temp;
  if (temp < 20) // cold
    lev_temp = 0b001;
  else if (temp < 50) // cold/warm
    lev_temp = 0b010;
  else if (temp < temp_min) // warm
    lev_temp = 0b011;
  else if (temp < temp_max) // warm/hot
    lev_temp = 0b100;
  else // hot
    lev_temp = 0b101;

  p_profile->page_1.temperature_state = lev_temp;

  // 9. fuel consumption
  // max value 0.1 wh/km per bit, max value=409.5 Wh/km
  p_profile->page_4.fuel_consumption = 0; // not yet implemented

  // set up the common gear state byte
  p_profile->common.gear_state = 0; // not yet implemented

  switch (event)
  {
    case ANT_LEV_PAGE_1_UPDATED:

      break;
    case ANT_LEV_PAGE_2_UPDATED:

      break;

    case ANT_LEV_PAGE_3_UPDATED:

      break;

    case ANT_LEV_PAGE_4_UPDATED:
      break;

    case ANT_LEV_PAGE_5_UPDATED:
      break;

    case ANT_LEV_PAGE_34_UPDATED:
      break;

    case ANT_LEV_PAGE_16_UPDATED:

      break;
    case ANT_LEV_PAGE_80_UPDATED:
      break;

    case ANT_LEV_PAGE_81_UPDATED:
      break;

    case ANT_LEV_PAGE_REQUEST_SUCCESS:
      break;

    case ANT_LEV_PAGE_REQUEST_FAILED:
      break;

    default:
      break;
  }
}

void antplus_lev_evt_handler_post(antplus_lev_profile_t *p_profile, antplus_lev_evt_t event)
{
  nrf_pwr_mgmt_feed();

  switch (event)
  {
    case ANT_LEV_PAGE_1_UPDATED:
      break;

    case ANT_LEV_PAGE_2_UPDATED:
      break;

    case ANT_LEV_PAGE_3_UPDATED:
      break;

    case ANT_LEV_PAGE_4_UPDATED:
      break;

    case ANT_LEV_PAGE_5_UPDATED:
      break;

    case ANT_LEV_PAGE_34_UPDATED:
      break;

    case ANT_LEV_PAGE_16_UPDATED:
      // assist level
      p_profile->common.travel_mode_state = p_profile->page_16.travel_mode;
      mp_ui_vars->ui8_assist_level = p_profile->page_16.travel_mode >> 3;

      // lights
      p_profile->common.system_state |= ((((uint8_t)p_profile->page_16.light) << 3));
      mp_ui_vars->ui8_lights = ((uint8_t)p_profile->page_16.light);
      break;

    case ANT_LEV_PAGE_80_UPDATED:
      break;

    case ANT_LEV_PAGE_81_UPDATED:
      break;

    case ANT_LEV_PAGE_REQUEST_SUCCESS:
      break;

    case ANT_LEV_PAGE_REQUEST_FAILED:
      break;

    default:
      break;
  }
}

void antplus_controls_evt_handler(antplus_controls_profile_t *p_profile, antplus_controls_evt_t event)
{
  nrf_pwr_mgmt_feed();

  switch (event)
  {
    case ANTPLUS_CONTROLS_PAGE_73_UPDATED:
      break;

    default:
      break;
  }
}

static void ant_setup(void)
{
  ret_code_t err_code;

  ant_search_config_t controls_search_config = DEFAULT_ANT_SEARCH_CONFIG(CONTROLS_CHANNEL_NUM);
  controls_search_config.low_priority_timeout = 2;  //5 seconds
  controls_search_config.high_priority_timeout = 5; //4*2.5 =10 seconds

  err_code = nrf_sdh_ant_enable();
  APP_ERROR_CHECK(err_code);

  err_code = ant_plus_key_set(ANTPLUS_NETWORK_NUM);
  APP_ERROR_CHECK(err_code);

  ui_vars_t *p_ui_vars = get_ui_vars();
  m_antplus_lev_channel_lev_sens_config.device_number = p_ui_vars->ui8_ant_device_id;

  err_code = antplus_lev_sens_init(&m_antplus_lev,
                               &m_antplus_lev_channel_lev_sens_config,
                               LEV_SENS_PROFILE_CONFIG(m_antplus_lev));
  APP_ERROR_CHECK(err_code);

  // fill manufacturer's common data page.
  m_antplus_lev.page_80 = ANT_COMMON_page80(LEV_HW_REVISION,
                                        LEV_MANUFACTURER_ID,
                                        LEV_MODEL_NUMBER);
  // fill product's common data page.
  m_antplus_lev.page_81 = ANT_COMMON_page81(LEV_SW_REVISION_MAJOR,
                                        LEV_SW_REVISION_MINOR,
                                        LEV_SERIAL_NUMBER);

  err_code = antplus_lev_sens_open(&m_antplus_lev);
  APP_ERROR_CHECK(err_code);


  // fill battery status data page.
  m_antplus_controls.page_82 = ANTPLUS_CONTROLS_PAGE82(295); // battery 2.95 volts, fully charged

  // fill manufacturer's common data page.
  m_antplus_controls.page_80 = ANT_COMMON_page80(CONTROLS_HW_REVISION,
                                                 CONTROLS_MANUFACTURER_ID,
                                                 CONTROLS_MODEL_NUMBER);
  // fill product's common data page.
  m_antplus_controls.page_81 = ANT_COMMON_page81(CONTROLS_SW_REVISION_MAJOR,
                                                 CONTROLS_SW_REVISION_MINOR,
                                                 CONTROLS_SERIAL_NUMBER);

  err_code = antplus_controls_sens_init(&m_antplus_controls, CONTROLS_SENS_CHANNEL_CONFIG(m_antplus_controls), CONTROLS_SENS_PROFILE_CONFIG(m_antplus_controls));
  APP_ERROR_CHECK(err_code);
  err_code = antplus_controls_sens_open(&m_antplus_controls);
  APP_ERROR_CHECK(err_code);
  err_code = ant_search_init(&controls_search_config);
  APP_ERROR_CHECK(err_code);
}

static void main_timer_timeout(void *p_context)
{
  UNUSED_PARAMETER(p_context);

  main_ticks++;

  if (main_ticks % (1000 / MSEC_PER_TICK) == 0)
    ui32_seconds_since_startup++;

  if ((main_ticks % (50 / MSEC_PER_TICK) == 0) && // every 50ms
      m_rt_processing_stop == false)
    rt_processing();
}

/// msecs since boot (note: will roll over every 50 days)
uint32_t get_time_base_counter_1ms()
{
  return main_ticks * MSEC_PER_TICK;
}

uint32_t get_seconds()
{
  return ui32_seconds_since_startup;
}

static void lfclk_config(void)
{
  uint32_t err_code = nrf_drv_clock_init();
  APP_ERROR_CHECK(err_code);

  nrf_drv_clock_lfclk_request(NULL);
}

static void init_app_timers(void)
{
  ret_code_t err_code;

  err_code = app_timer_init();
  APP_ERROR_CHECK(err_code);

  err_code = app_timer_create(&main_timer, APP_TIMER_MODE_REPEATED, main_timer_timeout);
  APP_ERROR_CHECK(err_code);

  err_code = app_timer_start(main_timer, MAIN_INTERVAL, NULL);
  APP_ERROR_CHECK(err_code);
}

/**@brief Function for initializing the BLE stack.
 *
 * @details Initializes the SoftDevice and the BLE event interrupt.
 */
static void ble_stack_init(void)
{
  ret_code_t err_code;

  err_code = nrf_sdh_enable_request();
  APP_ERROR_CHECK(err_code);

  // // Configure the BLE stack using the default settings.
  // // Fetch the start address of the application RAM.
  // uint32_t ram_start = 0;
  // err_code = nrf_sdh_ble_default_cfg_set(APP_BLE_CONN_CFG_TAG, &ram_start);
  // APP_ERROR_CHECK(err_code);

  // // Enable BLE stack.
  // err_code = nrf_sdh_ble_enable(&ram_start);
  // APP_ERROR_CHECK(err_code);

  // // Register a handler for BLE events.
  // NRF_SDH_BLE_OBSERVER(m_ble_observer, APP_BLE_OBSERVER_PRIO, ble_evt_handler, NULL);
}

/**@brief Function for the GAP initialization.
 *
 * @details This function sets up all the necessary GAP (Generic Access Profile) parameters of the
 *          device including the device name, appearance, and the preferred connection parameters.
 */
static void gap_params_init(void)
{
  ret_code_t err_code;
  ble_gap_conn_params_t gap_conn_params;
  ble_gap_conn_sec_mode_t sec_mode;

  BLE_GAP_CONN_SEC_MODE_SET_OPEN(&sec_mode);

  err_code = sd_ble_gap_device_name_set(&sec_mode,
                                        (const uint8_t *)DEVICE_NAME,
                                        strlen(DEVICE_NAME));
  APP_ERROR_CHECK(err_code);

  memset(&gap_conn_params, 0, sizeof(gap_conn_params));

  gap_conn_params.min_conn_interval = MIN_CONN_INTERVAL;
  gap_conn_params.max_conn_interval = MAX_CONN_INTERVAL;
  gap_conn_params.slave_latency = SLAVE_LATENCY;
  gap_conn_params.conn_sup_timeout = CONN_SUP_TIMEOUT;

  err_code = sd_ble_gap_ppcp_set(&gap_conn_params);
  APP_ERROR_CHECK(err_code);
}

/**@brief Function for initializing the GATT module.
 */
static void gatt_init(void)
{
  ret_code_t err_code = nrf_ble_gatt_init(&m_gatt, NULL);
  APP_ERROR_CHECK(err_code);

  // err_code = nrf_ble_gatt_att_mtu_periph_set(&m_gatt, NRF_SDH_BLE_GATT_MAX_MTU_SIZE);
  // APP_ERROR_CHECK(err_code);
}

/**@brief Function for handling Queued Write Module errors.
 *
 * @details A pointer to this function will be passed to each service which may need to inform the
 *          application about an error.
 *
 * @param[in]   nrf_error   Error code containing information about what went wrong.
 */
static void nrf_qwr_error_handler(uint32_t nrf_error)
{
  APP_ERROR_HANDLER(nrf_error);
}

static void ant_id_write_handler(uint16_t conn_handle, ble_ant_id_t *p_ant_id, uint8_t value)
{
  if (value == 0x99)
  {
    ui8_m_enter_bootloader = 1;
  }
  else
  {
    ui8_m_ant_device_id = value;
  }
}

/**@brief Function for initializing services that will be used by the application.
 */
static void services_init(void)
{
  ret_code_t err_code;
  nrf_ble_qwr_init_t qwr_init = {0};
  ble_ant_id_init_t init_ant_id = {0};

  // Initialize Queued Write Module.
  qwr_init.error_handler = nrf_qwr_error_handler;

  err_code = nrf_ble_qwr_init(&m_qwr, &qwr_init);
  APP_ERROR_CHECK(err_code);

  // ANT ID
  init_ant_id.ant_id_write_handler = ant_id_write_handler;

  err_code = ble_service_ant_id_init(&m_ble_ant_id_service, &init_ant_id);
  APP_ERROR_CHECK(err_code);

  // set actual ANT ID on the BLE service characteristic
  ble_ant_id_on_change(m_conn_handle, &m_ble_ant_id_service, mp_ui_vars->ui8_ant_device_id);
}

/**@brief Function for handling advertising events.
 *
 * @details This function will be called for advertising events which are passed to the application.
 *
 * @param[in] ble_adv_evt  Advertising event.
 */
static void on_adv_evt(ble_adv_evt_t ble_adv_evt)
{
  switch (ble_adv_evt)
  {
  case BLE_ADV_EVT_FAST:
    NRF_LOG_INFO("Fast advertising.");
    break;

  case BLE_ADV_EVT_IDLE:
    // sleep_mode_enter();
    break;

  default:
    break;
  }
}

/**@brief Function for initializing the Advertising functionality.
 *
 * @details Encodes the required advertising data and passes it to the stack.
 *          Also builds a structure to be passed to the stack when starting advertising.
 */
static void advertising_init(void)
{
  ret_code_t err_code;
  ble_advertising_init_t init;

  memset(&init, 0, sizeof(init));

  init.advdata.name_type = BLE_ADVDATA_FULL_NAME;
  init.advdata.include_appearance = true;
  init.advdata.flags = BLE_GAP_ADV_FLAGS_LE_ONLY_GENERAL_DISC_MODE;
  init.advdata.uuids_complete.uuid_cnt = sizeof(m_adv_uuids) / sizeof(m_adv_uuids[0]);
  init.advdata.uuids_complete.p_uuids = m_adv_uuids;

  init.config.ble_adv_fast_enabled = true;
  init.config.ble_adv_fast_interval = APP_ADV_INTERVAL;
  init.config.ble_adv_fast_timeout = APP_ADV_DURATION;
  init.evt_handler = on_adv_evt;

  err_code = ble_advertising_init(&m_advertising, &init);
  APP_ERROR_CHECK(err_code);

  ble_advertising_conn_cfg_tag_set(&m_advertising, APP_BLE_CONN_CFG_TAG);
}

/**@brief Function for handling the Connection Parameters Module.
 *
 * @details This function will be called for all events in the Connection Parameters Module that
 *          are passed to the application.
 *
 * @note All this function does is to disconnect. This could have been done by simply
 *       setting the disconnect_on_fail config parameter, but instead we use the event
 *       handler mechanism to demonstrate its use.
 *
 * @param[in] p_evt  Event received from the Connection Parameters Module.
 */
static void on_conn_params_evt(ble_conn_params_evt_t *p_evt)
{
  ret_code_t err_code;

  if (p_evt->evt_type == BLE_CONN_PARAMS_EVT_FAILED)
  {
    err_code = sd_ble_gap_disconnect(m_conn_handle, BLE_HCI_CONN_INTERVAL_UNACCEPTABLE);
    APP_ERROR_CHECK(err_code);
  }
}

/**@brief Function for handling a Connection Parameters error.
 *
 * @param[in] nrf_error  Error code containing information about what went wrong.
 */
static void conn_params_error_handler(uint32_t nrf_error)
{
  APP_ERROR_HANDLER(nrf_error);
}

/**@brief Function for initializing the Connection Parameters module.
 */
static void conn_params_init(void)
{
  ret_code_t err_code;
  ble_conn_params_init_t cp_init;

  memset(&cp_init, 0, sizeof(cp_init));

  cp_init.p_conn_params = NULL;
  cp_init.first_conn_params_update_delay = FIRST_CONN_PARAMS_UPDATE_DELAY;
  cp_init.next_conn_params_update_delay = NEXT_CONN_PARAMS_UPDATE_DELAY;
  cp_init.max_conn_params_update_count = MAX_CONN_PARAMS_UPDATE_COUNT;
  cp_init.start_on_notify_cccd_handle = BLE_GATT_HANDLE_INVALID;
  cp_init.disconnect_on_fail = false;
  cp_init.evt_handler = on_conn_params_evt;
  cp_init.error_handler = conn_params_error_handler;

  err_code = ble_conn_params_init(&cp_init);
  APP_ERROR_CHECK(err_code);
}

/**@brief Function for handling Peer Manager events.
 *
 * @param[in] p_evt  Peer Manager event.
 */
static void pm_evt_handler(pm_evt_t const *p_evt)
{
  ret_code_t err_code;

  pm_handler_on_pm_evt(p_evt);
  pm_handler_flash_clean(p_evt);

  switch (p_evt->evt_id)
  {
  case PM_EVT_PEERS_DELETE_SUCCEEDED:
    advertising_start(false);
    break;

  case PM_EVT_CONN_SEC_START:
    break;

  case PM_EVT_CONN_SEC_SUCCEEDED:
    // Update the rank of the peer.
    ble_conn_state_role(p_evt->conn_handle);
    break;

  case PM_EVT_CONN_SEC_FAILED:
    // In some cases, when securing fails, it can be restarted directly. Sometimes it can be
    // restarted, but only after changing some Security Parameters. Sometimes, it cannot be
    // restarted until the link is disconnected and reconnected. Sometimes it is impossible
    // to secure the link, or the peer device does not support it. How to handle this error
    // is highly application-dependent.
    m_conn_handle = BLE_CONN_HANDLE_INVALID;
    err_code = sd_ble_gap_disconnect(m_conn_handle, BLE_HCI_REMOTE_USER_TERMINATED_CONNECTION);
    // APP_ERROR_CHECK(err_code);
    break;

  case PM_EVT_CONN_SEC_CONFIG_REQ:
  {
    // A connected peer (central) is trying to pair, but the Peer Manager already has a bond
    // for that peer. Setting allow_repairing to false rejects the pairing request.
    // If this event is ignored (pm_conn_sec_config_reply is not called in the event
    // handler), the Peer Manager assumes allow_repairing to be false.
    pm_conn_sec_config_t conn_sec_config = {.allow_repairing = false};
    pm_conn_sec_config_reply(p_evt->conn_handle, &conn_sec_config);
  }
  break;

  case PM_EVT_STORAGE_FULL:
    // Run garbage collection on the flash.
    err_code = fds_gc();
    if (err_code == FDS_ERR_BUSY || err_code == FDS_ERR_NO_SPACE_IN_QUEUES)
    {
      // Retry.
    }
    else
    {
      APP_ERROR_CHECK(err_code);
    }
    break;

  default:
    break;
  }
}

/**@brief Function for the Peer Manager initialization.
 */
static void peer_manager_init(void)
{
  ble_gap_sec_params_t sec_param;
  ret_code_t err_code;

  err_code = pm_init();
  APP_ERROR_CHECK(err_code);

  memset(&sec_param, 0, sizeof(ble_gap_sec_params_t));

  // Security parameters to be used for all security procedures.
  sec_param.bond = SEC_PARAM_BOND;
  sec_param.mitm = SEC_PARAM_MITM;
  sec_param.lesc = SEC_PARAM_LESC;
  sec_param.keypress = SEC_PARAM_KEYPRESS;
  sec_param.io_caps = SEC_PARAM_IO_CAPABILITIES;
  sec_param.oob = SEC_PARAM_OOB;
  sec_param.min_key_size = SEC_PARAM_MIN_KEY_SIZE;
  sec_param.max_key_size = SEC_PARAM_MAX_KEY_SIZE;
  sec_param.kdist_own.enc = 1;
  sec_param.kdist_own.id = 1;
  sec_param.kdist_peer.enc = 1;
  sec_param.kdist_peer.id = 1;

  err_code = pm_sec_params_set(&sec_param);
  APP_ERROR_CHECK(err_code);

  err_code = pm_register(pm_evt_handler);
  APP_ERROR_CHECK(err_code);
}

void ble_init(void)
{
  ble_stack_init();
  // gap_params_init();
  // gatt_init();
  // services_init();
  // advertising_init();
  // conn_params_init();
  // peer_manager_init();
  // advertising_start(true);
}

void eeprom_write_variables_and_reset(void)
{
  // NOTE that flash of EEPROM does not work on an interrupt like on the ant_id_write_handler(), hence it is done here on main
  eeprom_write_variables();

  // wait some time to make sure eeprom is written
  nrf_delay_ms(1000);

  // finally reset so the new ANT ID will take effect
  NVIC_SystemReset();
}

// called every 50ms
void motor_power_manage(void)
{
  static uint8_t counter;

  switch (m_motor_state)
  {
  case MOTOR_STATE_OFF_START:
    motor_power_enable(false);
    counter = 20; // 1 second
    m_motor_state = MOTOR_STATE_OFF_WAIT;
    break;

  case MOTOR_STATE_OFF_WAIT:
    if (counter > 0)
      counter--;
    if (counter == 0)
    {
      // reset state variables
      if (g_motor_init_state != MOTOR_INIT_OFF)
      {
        led_sequence_play(LED_EVENT_MOTOR_OFF);
        led_sequence_play(LED_EVENT_WAIT_1S);
        disp_soc(ui8_g_battery_soc / 10);
      }
      uart_reset_rx_buffer();
      g_motor_init_state = MOTOR_INIT_OFF;
      g_motor_init_state_conf = MOTOR_INIT_CONFIG_SEND_CONFIG;
      ui8_g_motor_init_status = MOTOR_INIT_STATUS_RESET;

      m_motor_state = MOTOR_STATE_OFF;
    }
    break;

  case MOTOR_STATE_OFF:
    // do nothing
    break;

  case MOTOR_STATE_ON_START:
    motor_power_enable(true);
    g_motor_init_state = MOTOR_INIT_GET_MOTOR_ALIVE;
    m_motor_state = MOTOR_STATE_ON;
    break;

  case MOTOR_STATE_ON:
    // do nothing
    break;
  }
}

void walk_assist_state(void)
{
  // kevinh - note on the sw102 we show WALK in the box normally used for BRAKE display - the display code is handled there now
  if (ui_vars.ui8_walk_assist_feature_enabled)
  {
    // if down button is still pressed
    if (ui_vars.ui8_walk_assist && buttons_get_down_state())
    {
      ui8_walk_assist_timeout = 2; // 0.2 seconds
    }
    else if (buttons_get_down_state() == 0 && --ui8_walk_assist_timeout == 0)
    {
      led_sequence_cancel_play_until();
      ui_vars.ui8_walk_assist = 0;
      ui8_walk_assist_state_process_locally = 0;
    }
  }
  else
  {
    ui_vars.ui8_walk_assist = 0;
    ui8_walk_assist_state_process_locally = 0;
  }
}

void brakeLights(void)
{
  if (ui8_braking_led_state != ui_vars.ui8_braking)
  {
    ui8_braking_led_state = ui_vars.ui8_braking;

    if (ui8_braking_led_state == 1)
      led_sequence_play_now(LED_EVENT_BRAKE_ON);
    else
      led_sequence_play_now(LED_EVENT_BRAKE_OFF);

    // Todo - add code to replicate brake light signal on NRF pin...
  }
}

void system_power_off(uint8_t updateDistanceOdo)
{
  (void)updateDistanceOdo; // for future implementation ??

  display_off();

  // turn off the motor controller
  motor_power_enable(false);
  m_motor_state = MOTOR_STATE_OFF_START;

  // update variables before save them
  ui_vars.ui32_wh_x10_offset = ui_vars.ui32_wh_x10;

  // save the variables on EEPROM
  eeprom_write_variables();

  // FIXME: wait for flash write to complete before powering down
  nrf_delay_ms(500);

  // disable softdevice || THIS fails!!
  // uint32_t  err_code = nrf_sdh_disable_request();
  // APP_ERROR_CHECK(err_code);

  // make sure user did release the on/off button
  while (buttons_get_onoff_state())
    ;

  // this will enable wakeup from ultra low power mode
  nrf_gpio_cfg_sense_input(ONOFF__PIN, GPIO_PIN_CNF_PULL_Pullup, GPIO_PIN_CNF_SENSE_Low);

  nrf_delay_ms(1000);

  // will enter in low power mode and block here until on/off button is pressed
  nrf_pwr_mgmt_run();

  // wait for user press on/off button
  while (buttons_get_onoff_state() == 0)
    ;

  // fresh restart
  sd_nvic_SystemReset();

  // block here but we should not get here anyway
  while (1)
    ;
}

int main(void)
{
  mp_ui_vars = get_ui_vars();
  mp_rt_vars = get_rt_vars();

  // Initialize the async SVCI interface to bootloader before any interrupts are enabled.
  pins_init();
  lfclk_config(); // needed by the APP_TIMER
  init_app_timers();
  eeprom_init();

  // below is what I had to do to get NVIC_SystemReset() not to hangup.
  // the s340 sd if what is preventing the restart into the bootloader, so it is important to reset before bluetooth starts.
  // basically, the user changes the ANT_ID to 0x99 , the firmware reboots as normal and we catch the change here before bluetooth starts
  // it now works in debug mode!
  if (mp_ui_vars->ui8_enter_bootloader) // check to see if reboot into the bootloader is needed
  {
    mp_ui_vars->ui8_enter_bootloader = 0;
    nrf_power_gpregret_set(BOOTLOADER_DFU_START); // set the dfu register
    bsp_board_led_on(LED_B__PIN);                 // Indicate about to enter bootloader
    nrf_delay_ms(1000);                           // wait for write to complete
    eeprom_write_variables();
    nrf_delay_ms(3000); // wait for write to complete
    NVIC_SystemReset(); // reboot into bootloader
  }

  ble_init();
  ant_setup();
#ifdef MOTOR_TSDZ2
  uart_init();
#endif

  led_init();
  led_set_global_brightness(7); // For wireless controller - brightest
  ui_vars.ui8_street_mode_function_enabled = 1;

  // setup this member variable ui8_m_ant_device_id
  ui8_m_ant_device_id = mp_ui_vars->ui8_ant_device_id;
  uint32_t ui32_rt_last_run_time = 0;
  uint32_t ui32_dfucheck_last_run_time = 0;
  uint8_t ui8_ble_connected_shown = 0;

  led_sequence_play(LED_EVENT_WIRELESS_BOARD_POWER_ON);

#ifdef MOTOR_TSDZ2
  #ifdef DISPLAY_I2C
    ssd1306_init_i2c();
  #elif defined(DISPLAY_SPI)
    // SPI is used to display
    spi_init();
  #else
  #error MUST define DISPLAY_I2C or DISPLAY_SPI
  #endif
#elif defined(MOTOR_BAFANG)
  // SPI is used to display and CAN module
  spi_init();
  CANSPI_Initialize();
#else
  #error MUST define MOTOR_TSDZ2 or MOTOR_BAFANG
#endif

  // init the display
  display_init();
  screen_init();

  // show the first screen: boot screen
#ifndef DEVELOPMENT
  screenShow(&bootScreen);
#else
  screenShow(&mainScreen1);
#endif

  while (1)
  {
    // every 50 ms
    uint32_t ui32_time_now = get_time_base_counter_1ms();
    if ((ui32_time_now - ui32_rt_last_run_time) >= 50)
    {
      ui32_rt_last_run_time = ui32_time_now;
      // exchange data from realtime layer to UI layer
      // do this in atomic way, disabling the real time layer (should be no problem as
      // copy_rt_to_ui_vars() should be fast and take a small piece of the 50ms periodic realtime layer processing
      rt_processing_stop();
      copy_rt_ui_vars();
      rt_processing_start();

      mainscreen_idle();

      motor_power_manage();

      //   if (ui8_walk_assist_state_process_locally) walk_assist_state();

      //   streetMode();
      brakeLights();

      if ((m_conn_handle != BLE_CONN_HANDLE_INVALID) && (!ui8_ble_connected_shown))
      {
        ui8_ble_connected_shown = 1;
        led_sequence_play(LED_EVENT_BLUETOOTH_CONNECT);
      }

      if ((m_conn_handle == BLE_CONN_HANDLE_INVALID) && (ui8_ble_connected_shown))
      {
        ui8_ble_connected_shown = 0;
        led_sequence_play(LED_EVENT_BLUETOOTH_DISCONNECT);
      }
    }

    // every 1 second
    ui32_time_now = get_time_base_counter_1ms();
    if ((ui32_time_now - ui32_dfucheck_last_run_time) >= 1000)
    {
      ui32_dfucheck_last_run_time = ui32_time_now;
      // see if DFU reboot is needed

      // see if there was a change to the ANT ID
      if (ui8_m_ant_device_id != mp_ui_vars->ui8_ant_device_id)
      {
        mp_ui_vars->ui8_ant_device_id = ui8_m_ant_device_id;
        eeprom_write_variables_and_reset();
      }

      // see if there a request to enter in bootloader
      if (ui8_m_enter_bootloader)
      {
        ui8_m_enter_bootloader = 0;
        mp_ui_vars->ui8_enter_bootloader = 1;
        eeprom_write_variables_and_reset();
      }

      // see if there was a change to the ANT ID
      if (ui8_m_flash_configurations)
      {
        ui8_m_flash_configurations = 0;
        eeprom_write_variables();
      }
    }

#ifdef MOTOR_TSDZ2

#elif defined(MOTOR_BAFANG)
    // process the CAN messages
    // call as fast as possible
    ui32_time_now = get_time_base_counter_1ms();
    can_processing(ui32_time_now);
#endif
  }
}
