OpenSourceEBike/EV_Display_Bluetooth_Ant/firmware/display/buttons.c

/*
 * Bafang / Aptdevelop 850C color display  firmware
 *
 * Copyright (C) Casainho, 2018.
 *
 * Released under the GPL License, Version 3
 */

#include "stdio.h"

#include "buttons.h"
#include "state.h"
#include "timer.h"
#include "pins.h"
#include "buttons.h"

#define TIME_1 1500 // changed to 1.5 sec because 2 secs seems too long to me and a user asked for it also
#define TIME_2 200
#define TIME_3 300
#define TIME_4 1000

#define BUTTONS_CLOCK_MS 50
#define MS_TO_TICKS(a) ((a) / (BUTTONS_CLOCK_MS))

static uint32_t ui32_onoff_button_state = 0;
static uint32_t ui32_onoff_button_state_counter = 0;
static uint32_t ui32_down_button_state = 0;
static uint32_t ui32_down_button_state_counter = 0;
static uint32_t ui32_up_button_state = 0;
static uint32_t ui32_up_button_state_counter = 0;
static uint32_t ui32_m_button_state = 0;
static uint32_t ui32_m_button_state_counter = 0;
buttons_events_t buttons_events = 0;

uint32_t ui32_up_presstime = 0;
uint32_t ui32_down_presstime = 0;
uint32_t ui32_onoff_presstime = 0;
uint32_t ui32_m_presstime = 0;

static uint32_t ui32_m_clear_event = 0;

/* Buttons */
Button buttonDWN, buttonUP, buttonPWR, buttonM;

/**
 * @brief Init button struct. Call once.
 */
void InitButton(Button* button, uint32_t pin_number, nrf_gpio_pin_pull_t pull_config, button_active_state active_state)
{
  /* Init GPIO */
  nrf_gpio_cfg_input(pin_number, pull_config);

  button->ActiveState = active_state;
  button->PinNumber = pin_number;
}

/**
 * @brief Process button struct. Call every 10 ms.
 */
bool PollButton(Button* button)
{
  uint32_t pinState = nrf_gpio_pin_read(button->PinNumber);
  return !pinState; // hardware state inverted
}

uint32_t buttons_get_up_state (void)
{
  if (!ui_vars.ui8_buttons_up_down_invert)
  {
    return PollButton(&buttonUP);
  }
  else
  {
    return PollButton(&buttonDWN);
  }
}

uint32_t buttons_get_down_state (void)
{
  if (ui_vars.ui8_buttons_up_down_invert)
  {
    return PollButton(&buttonUP);
  }
  else
  {
    return PollButton(&buttonDWN);
  }
}

uint32_t buttons_get_onoff_state (void)
{
  return PollButton(&buttonPWR);
}

uint32_t buttons_get_m_state (void)
{
  return PollButton(&buttonM);
}

uint32_t buttons_get_m_click_event(void) {
	return (buttons_events & M_CLICK) ? 1 : 0;
}

uint32_t buttons_get_m_long_click_event(void) {
	return (buttons_events & M_LONG_CLICK) ? 1 : 0;
}

void buttons_clear_m_click_event(void) {
	buttons_events &= ~M_CLICK;
}

void buttons_clear_m_long_click_event(void) {
	buttons_events &= ~M_LONG_CLICK;
}

uint32_t buttons_get_up_click_event(void) {
	return (buttons_events & UP_CLICK) ? 1 : 0;
}

uint32_t buttons_get_up_long_click_event(void) {
	return (buttons_events & UP_LONG_CLICK) ? 1 : 0;
}

void buttons_clear_up_click_event(void) {
	buttons_events &= ~UP_CLICK;
}

void buttons_clear_up_long_click_event(void) {
	buttons_events &= ~UP_LONG_CLICK;
}

uint32_t buttons_get_down_click_event(void) {
	return (buttons_events & DOWN_CLICK) ? 1 : 0;
}

uint32_t buttons_get_down_long_click_event(void) {
	return (buttons_events & DOWN_LONG_CLICK) ? 1 : 0;
}

void buttons_clear_down_click_event(void) {
	buttons_events &= ~DOWN_CLICK;
}

void buttons_clear_down_long_click_event(void) {
	buttons_events &= ~DOWN_LONG_CLICK;
}

uint32_t buttons_get_onoff_click_event(void) {
	return (buttons_events & ONOFF_CLICK) ? 1 : 0;
}

uint32_t buttons_get_onoff_long_click_event(void) {
	return (buttons_events & ONOFF_LONG_CLICK) ? 1 : 0;
}

uint32_t buttons_get_onoff_click_long_click_event(void) {
	return (buttons_events & ONOFF_CLICK_LONG_CLICK) ? 1 : 0;
}

void buttons_clear_onoff_click_event(void) {
	buttons_events &= ~ONOFF_CLICK;
}

void buttons_clear_onoff_click_long_click_event(void) {
	buttons_events &= ~ONOFF_CLICK_LONG_CLICK;
}

void buttons_clear_onoff_long_click_event(void) {
	buttons_events &= ~ONOFF_LONG_CLICK;
}

uint32_t buttons_get_up_down_click_event(void) {
	return (buttons_events & UPDOWN_LONG_CLICK) ? 1 : 0;
}

void buttons_clear_up_down_click_event(void) {
	buttons_events &= ~UPDOWN_LONG_CLICK;
}

buttons_events_t buttons_get_events(void) {
	return buttons_events;
}

void buttons_set_events(buttons_events_t events) {
	buttons_events |= events;
}

void buttons_clear_all_events(void) {
	ui32_m_clear_event = 1;
	buttons_events = 0;
	ui32_onoff_button_state = 0;
  ui32_m_button_state = 0;
	ui32_up_button_state = 0;
	ui32_down_button_state = 0;
}

void buttons_clock(void) {
	// exit if any button is pressed after clear event
	if ((ui32_m_clear_event)
			&& (buttons_get_up_state() || buttons_get_down_state() || buttons_get_onoff_state() || buttons_get_m_state())) {
		return;
	} else {
		ui32_m_clear_event = 0;
	}

	switch (ui32_onoff_button_state) {
	case 0:
		if (buttons_get_onoff_state()) {
			ui32_onoff_button_state_counter = 0;
			ui32_onoff_button_state = 1;
		}
		break;

	case 1:
		ui32_onoff_button_state_counter++;

		// event long click
		if (ui32_onoff_button_state_counter > MS_TO_TICKS(TIME_1)) {
			buttons_set_events(ONOFF_LONG_CLICK);
			ui32_onoff_button_state = 2;
			break;
		}

		// if button release
		if (!buttons_get_onoff_state()) {
			// let's validade if will be a quick click + long click
			if (ui32_onoff_button_state_counter <= MS_TO_TICKS(TIME_2)) {
				ui32_onoff_button_state_counter = 0;
				ui32_onoff_button_state = 3;
				break;
			}
			// event click
			else {
				buttons_set_events(ONOFF_CLICK);
				ui32_onoff_button_state = 0;
				break;
			}
		}
		break;

	case 2:
		// wait for button release
		if (!buttons_get_onoff_state()) {
			ui32_onoff_button_state = 0;
			break;
		}
		break;

	case 3:
		ui32_onoff_button_state_counter++;

		// on next step, start counting for long click
		if (buttons_get_onoff_state()) {
			ui32_onoff_button_state_counter = 0;
			ui32_onoff_button_state = 4;
			break;
		}

		// event click
		if (ui32_onoff_button_state_counter > MS_TO_TICKS(TIME_3)) {
			buttons_set_events(ONOFF_CLICK);
			ui32_onoff_button_state = 0;
			break;
		}
		break;

	case 4:
		ui32_onoff_button_state_counter++;

		// event click, but this time it is: click + long click
		if (ui32_onoff_button_state_counter > MS_TO_TICKS(TIME_4)) {
			buttons_set_events(ONOFF_CLICK_LONG_CLICK);
			ui32_onoff_button_state = 2;
			break;
		}

		// button release
		if (!buttons_get_onoff_state()) {
			buttons_set_events(ONOFF_CLICK);
			ui32_onoff_button_state = 0;
			break;
		}
		break;

	default:
		ui32_onoff_button_state = 0;
		break;
	}

	switch (ui32_up_button_state) {
    case 0:
      if (buttons_get_up_state()) {
        ui32_up_button_state_counter = 0;
        ui32_up_button_state = 1;
      }
      break;

    case 1:
      // event long click
      if (ui32_up_button_state_counter++ > MS_TO_TICKS(TIME_1)) {
        if (buttons_get_onoff_state() &&
            buttons_get_down_state()) {
          // reset all events and machine state of others
          buttons_clear_all_events();
          ui32_down_button_state = 0;
          ui32_onoff_button_state = 0;
          ui32_m_button_state = 0;
          buttons_set_events(ONOFFUPDOWN_LONG_CLICK);
        } else if (buttons_get_onoff_state()) {
          buttons_set_events(ONOFFUP_LONG_CLICK);
        } else if (buttons_get_down_state()) {
          buttons_set_events(UPDOWN_LONG_CLICK);
        } else {
          buttons_set_events(UP_LONG_CLICK);
        }

        ui32_up_button_state = 2;
        ui32_up_button_state_counter = 0;
        break;
      }

      // if button release
      if (!buttons_get_up_state()) {
        buttons_set_events(UP_CLICK);
        ui32_up_button_state = 0;
        break;
      }
      break;

    case 2:
      // wait for button release
      if (!buttons_get_up_state()) {
        ui32_up_button_state = 0;
      }
      break;

    default:
      ui32_up_button_state = 0;
      break;
	}

  switch (ui32_down_button_state) {
    case 0:
      if (buttons_get_down_state()) {
        ui32_down_button_state_counter = 0;
        ui32_down_button_state = 1;
      }
      break;

    case 1:
      // event long click
      if (ui32_down_button_state_counter++ > MS_TO_TICKS(TIME_1)) {
        if (buttons_get_onoff_state() &&
            buttons_get_up_state()) {
          // reset all events and machine state of others
          buttons_clear_all_events();
          ui32_up_button_state = 0;
          ui32_onoff_button_state = 0;
          ui32_m_button_state = 0;
          buttons_set_events(ONOFFUPDOWN_LONG_CLICK);
        } else if (buttons_get_onoff_state()) {
          buttons_set_events(ONOFFDOWN_LONG_CLICK);
        } else if (buttons_get_up_state()) {
          buttons_set_events(UPDOWN_LONG_CLICK);
        } else {
          buttons_set_events(DOWN_LONG_CLICK);
        }

        ui32_down_button_state = 2;
        ui32_down_button_state_counter = 0;
        break;
      }

      // if button release
      if (!buttons_get_down_state()) {
        buttons_set_events(DOWN_CLICK);
        ui32_down_button_state = 0;
        break;
      }
      break;

    case 2:
      // wait for button release
      if (!buttons_get_down_state()) {
        ui32_down_button_state = 0;
      }
      break;

    default:
      ui32_down_button_state = 0;
      break;
  }

  switch (ui32_m_button_state) {
    case 0:
      if (buttons_get_m_state()) {
        ui32_m_button_state_counter = 0;
        ui32_m_button_state = 1;
      }
      break;

    case 1:
      ui32_m_button_state_counter++;

      // event long click
      if (ui32_m_button_state_counter > MS_TO_TICKS(TIME_1)) {
        buttons_set_events(M_LONG_CLICK);
        ui32_m_button_state = 2;
        break;
      }

      // if button release
      if (!buttons_get_m_state()) {
        // let's validade if will be a quick click + long click
        if (ui32_m_button_state_counter <= MS_TO_TICKS(TIME_2)) {
          ui32_m_button_state_counter = 0;
          ui32_m_button_state = 3;
          break;
        }
        // event click
        else {
          buttons_set_events(M_CLICK);
          ui32_m_button_state = 0;
          break;
        }
      }
      break;

    case 2:
      // wait for button release
      if (!buttons_get_m_state()) {
        ui32_m_button_state = 0;
        break;
      }
      break;

    case 3:
      ui32_m_button_state_counter++;

      // on next step, start counting for long click
      if (buttons_get_m_state()) {
        ui32_m_button_state_counter = 0;
        ui32_m_button_state = 4;
        break;
      }

      // event click
      if (ui32_m_button_state_counter > MS_TO_TICKS(TIME_3)) {
        buttons_set_events(M_CLICK);
        ui32_m_button_state = 0;
        break;
      }
      break;

    case 4:
      ui32_m_button_state_counter++;

      // event click, but this time it is: click + long click
      if (ui32_m_button_state_counter > MS_TO_TICKS(TIME_4)) {
        buttons_set_events(M_CLICK_LONG_CLICK);
        ui32_m_button_state = 2;
        break;
      }

      // button release
      if (!buttons_get_m_state()) {
        buttons_set_events(M_CLICK);
        ui32_m_button_state = 0;
        break;
      }
      break;

    default:
      ui32_m_button_state = 0;
      break;
  }
}
