OpenSourceEBike/EV_Display_Bluetooth_Ant/firmware/display/can/CANSPI.c

#include "CANSPI.h"
#include "MCP2515.h"

#include <stdio.h>
#include <stdbool.h>

/** Local Function Prototypes */  
static uint32_t convertReg2ExtendedCANid(uint8_t tempRXBn_EIDH, uint8_t tempRXBn_EIDL, uint8_t tempRXBn_SIDH, uint8_t tempRXBn_SIDL);
static uint32_t convertReg2StandardCANid(uint8_t tempRXBn_SIDH, uint8_t tempRXBn_SIDL) ;
static void convertCANid2Reg(uint32_t tempPassedInID, uint8_t canIdType, id_reg_t *passedIdReg);

/** Local Variables */ 
ctrl_status_t ctrlStatus;
ctrl_error_status_t errorStatus;
id_reg_t idReg;

/** CAN SPI APIs */ 

/* Sleep 모드 진입 */
void CANSPI_Sleep(void)
{
  /* Clear CAN bus wakeup interrupt */
  MCP2515_BitModify(MCP2515_CANINTF, 0x40, 0x00);        
  
  /* Enable CAN bus activity wakeup */
  MCP2515_BitModify(MCP2515_CANINTE, 0x40, 0x40);        
  
  MCP2515_SetSleepMode();
}

void CANSPI_Loopback(void)
{
  /* Clear CAN bus wakeup interrupt */
  MCP2515_BitModify(MCP2515_CANINTF, 0x40, 0x00);        
  
  /* Enable CAN bus activity wakeup */
  MCP2515_BitModify(MCP2515_CANINTE, 0x40, 0x40);        
  
  MCP2515_SetLoopbackMode();
}

/* CAN 통신 초기화  */
bool CANSPI_Initialize(void)
{
  RXF0 RXF0reg;
  RXF1 RXF1reg;
  RXF2 RXF2reg;
  RXF3 RXF3reg;
  RXF4 RXF4reg;
  RXF5 RXF5reg;
  RXM0 RXM0reg;
  RXM1 RXM1reg;
      
  /* Rx Mask values 초기화 */
  RXM0reg.RXM0SIDH = 0x00;
  RXM0reg.RXM0SIDL = 0x00;
  RXM0reg.RXM0EID8 = 0x00;
  RXM0reg.RXM0EID0 = 0x00;
  
  RXM1reg.RXM1SIDH = 0x00;
  RXM1reg.RXM1SIDL = 0x00;
  RXM1reg.RXM1EID8 = 0x00;
  RXM1reg.RXM1EID0 = 0x00;
  
  /* Rx Filter values 초기화 */
  RXF0reg.RXF0SIDH = 0x00;      
  RXF0reg.RXF0SIDL = 0x00;      //Starndard Filter
  RXF0reg.RXF0EID8 = 0x00;
  RXF0reg.RXF0EID0 = 0x00;
  
  RXF1reg.RXF1SIDH = 0x00;
  RXF1reg.RXF1SIDL = 0x08;      //Exntended Filter
  RXF1reg.RXF1EID8 = 0x00;
  RXF1reg.RXF1EID0 = 0x00;
  
  RXF2reg.RXF2SIDH = 0x00;
  RXF2reg.RXF2SIDL = 0x00;
  RXF2reg.RXF2EID8 = 0x00;
  RXF2reg.RXF2EID0 = 0x00;
  
  RXF3reg.RXF3SIDH = 0x00;
  RXF3reg.RXF3SIDL = 0x00;
  RXF3reg.RXF3EID8 = 0x00;
  RXF3reg.RXF3EID0 = 0x00;
  
  RXF4reg.RXF4SIDH = 0x00;
  RXF4reg.RXF4SIDL = 0x00;
  RXF4reg.RXF4EID8 = 0x00;
  RXF4reg.RXF4EID0 = 0x00;
  
  RXF5reg.RXF5SIDH = 0x00;
  RXF5reg.RXF5SIDL = 0x08;
  RXF5reg.RXF5EID8 = 0x00;
  RXF5reg.RXF5EID0 = 0x00;

  /* Configuration 모드로 설정 */
  if(!MCP2515_SetConfigMode())
    return false;
  
  /* Filter & Mask 값 설정 */
  MCP2515_WriteByteSequence(MCP2515_RXM0SIDH, MCP2515_RXM0EID0, &(RXM0reg.RXM0SIDH));
  MCP2515_WriteByteSequence(MCP2515_RXM1SIDH, MCP2515_RXM1EID0, &(RXM1reg.RXM1SIDH));
  MCP2515_WriteByteSequence(MCP2515_RXF0SIDH, MCP2515_RXF0EID0, &(RXF0reg.RXF0SIDH));
  MCP2515_WriteByteSequence(MCP2515_RXF1SIDH, MCP2515_RXF1EID0, &(RXF1reg.RXF1SIDH));
  MCP2515_WriteByteSequence(MCP2515_RXF2SIDH, MCP2515_RXF2EID0, &(RXF2reg.RXF2SIDH));
  MCP2515_WriteByteSequence(MCP2515_RXF3SIDH, MCP2515_RXF3EID0, &(RXF3reg.RXF3SIDH));
  MCP2515_WriteByteSequence(MCP2515_RXF4SIDH, MCP2515_RXF4EID0, &(RXF4reg.RXF4SIDH));
  MCP2515_WriteByteSequence(MCP2515_RXF5SIDH, MCP2515_RXF5EID0, &(RXF5reg.RXF5SIDH));
  
  /* Accept All (Standard + Extended) */
  MCP2515_WriteByte(MCP2515_RXB0CTRL, 0x04);    //Enable BUKT, Accept Filter 0
  MCP2515_WriteByte(MCP2515_RXB1CTRL, 0x01);    //Accept Filter 1
      
  /* 
  * tq = 2 * (brp(0) + 1) / 16000000 = 0.125us
  * tbit = (SYNC_SEG(1 fixed) + PROP_SEG + PS1 + PS2)
  * tbit = 1tq + 5tq + 6tq + 4tq = 16tq
  * 16tq = 2us = 500kbps
  */
  
  /* 00(SJW 1tq) 000000 */  
  MCP2515_WriteByte(MCP2515_CNF1, 0x00);
  
  /* 1 1 100(5tq) 101(6tq) */  
  MCP2515_WriteByte(MCP2515_CNF2, 0xE5);
  
  /* 1 0 000 011(4tq) */  
  MCP2515_WriteByte(MCP2515_CNF3, 0x83);
  
  /* Normal 모드로 설정 */
  if(!MCP2515_SetNormalMode())
    return false;
  
  return true;
}

/* CAN 메시지 전송 */
uint8_t CANSPI_Transmit(uCAN_MSG *tempCanMsg) 
{
  uint8_t returnValue = 0;
  
  idReg.tempSIDH = 0;
  idReg.tempSIDL = 0;
  idReg.tempEID8 = 0;
  idReg.tempEID0 = 0;
  
  ctrlStatus.ctrl_status = MCP2515_ReadStatus();
  
  /* 현재 Transmission 이 Pending 되지 않은 버퍼를 찾아서 전송한다. */
  if (ctrlStatus.TXB0REQ != 1)
  {
    /* ID Type에 맞게 변환 */
    convertCANid2Reg(tempCanMsg->frame.id, tempCanMsg->frame.idType, &idReg);
    
    /* Tx Buffer에 전송할 데이터 Loading */
    MCP2515_LoadTxSequence(MCP2515_LOAD_TXB0SIDH, &(idReg.tempSIDH), tempCanMsg->frame.dlc, &(tempCanMsg->frame.data0));
    
    /* Tx Buffer의 데이터 전송요청 */
    MCP2515_RequestToSend(MCP2515_RTS_TX0);
    
    returnValue = 1;
  }
  else if (ctrlStatus.TXB1REQ != 1)
  {
    convertCANid2Reg(tempCanMsg->frame.id, tempCanMsg->frame.idType, &idReg);
    
    MCP2515_LoadTxSequence(MCP2515_LOAD_TXB1SIDH, &(idReg.tempSIDH), tempCanMsg->frame.dlc, &(tempCanMsg->frame.data0));
    MCP2515_RequestToSend(MCP2515_RTS_TX1);
    
    returnValue = 1;
  }
  else if (ctrlStatus.TXB2REQ != 1)
  {
    convertCANid2Reg(tempCanMsg->frame.id, tempCanMsg->frame.idType, &idReg);
    
    MCP2515_LoadTxSequence(MCP2515_LOAD_TXB2SIDH, &(idReg.tempSIDH), tempCanMsg->frame.dlc, &(tempCanMsg->frame.data0));
    MCP2515_RequestToSend(MCP2515_RTS_TX2);
    
    returnValue = 1;
  }
  
  return (returnValue);
}

/* CAN 메시지 수신 */
uint8_t CANSPI_Receive(uCAN_MSG *tempCanMsg) 
{
  uint8_t returnValue = 0;
  rx_reg_t rxReg;
  ctrl_rx_status_t rxStatus;
  
  rxStatus.ctrl_rx_status = MCP2515_GetRxStatus();
  
  /* 버퍼에 수신된 메시지가 있는지 확인 */
  if (rxStatus.rxBuffer != 0)
  {
    /* 어떤 버퍼에 메시지가 있는지 확인 후 처리 */
    if ((rxStatus.rxBuffer == MSG_IN_RXB0)|(rxStatus.rxBuffer == MSG_IN_BOTH_BUFFERS))
    {
      MCP2515_ReadRxSequence(MCP2515_READ_RXB0SIDH, rxReg.rx_reg_array, sizeof(rxReg.rx_reg_array));
    }
    else if (rxStatus.rxBuffer == MSG_IN_RXB1)
    {
      MCP2515_ReadRxSequence(MCP2515_READ_RXB1SIDH, rxReg.rx_reg_array, sizeof(rxReg.rx_reg_array));
    }
    
    /* Extended 타입 */
    if (rxStatus.msgType == dEXTENDED_CAN_MSG_ID_2_0B)
    {
      tempCanMsg->frame.idType = (uint8_t) dEXTENDED_CAN_MSG_ID_2_0B;
      tempCanMsg->frame.id = convertReg2ExtendedCANid(rxReg.RXBnEID8, rxReg.RXBnEID0, rxReg.RXBnSIDH, rxReg.RXBnSIDL);
    } 
    else 
    {
      /* Standard 타입 */
      tempCanMsg->frame.idType = (uint8_t) dSTANDARD_CAN_MSG_ID_2_0B;
      tempCanMsg->frame.id = convertReg2StandardCANid(rxReg.RXBnSIDH, rxReg.RXBnSIDL);
    }
    
    tempCanMsg->frame.dlc   = rxReg.RXBnDLC;
    tempCanMsg->frame.data0 = rxReg.RXBnD0;
    tempCanMsg->frame.data1 = rxReg.RXBnD1;
    tempCanMsg->frame.data2 = rxReg.RXBnD2;
    tempCanMsg->frame.data3 = rxReg.RXBnD3;
    tempCanMsg->frame.data4 = rxReg.RXBnD4;
    tempCanMsg->frame.data5 = rxReg.RXBnD5;
    tempCanMsg->frame.data6 = rxReg.RXBnD6;
    tempCanMsg->frame.data7 = rxReg.RXBnD7;
    
    returnValue = 1;
  }
  
  return (returnValue);
}

/* 수신 버퍼에 메시지가 있는지 체크 */
uint8_t CANSPI_messagesInBuffer(void)
{
  uint8_t messageCount = 0;
  
  ctrlStatus.ctrl_status = MCP2515_ReadStatus();
  
  if(ctrlStatus.RX0IF != 0)
  {
    messageCount++;
  }
  
  if(ctrlStatus.RX1IF != 0)
  {
    messageCount++;
  }
  
  return (messageCount);
}

/* CAN BUS 가 Offline 인지 체크 */
uint8_t CANSPI_isBussOff(void)
{
  uint8_t returnValue = 0;
  
  errorStatus.error_flag_reg = MCP2515_ReadByte(MCP2515_EFLG);
  
  if(errorStatus.TXBO == 1)
  {
    returnValue = 1;
  }
  
  return (returnValue);
}

/* Rx Passive Error 상태인지 체크 */
uint8_t CANSPI_isRxErrorPassive(void)
{
  uint8_t returnValue = 0;
  
  errorStatus.error_flag_reg = MCP2515_ReadByte(MCP2515_EFLG);
  
  if(errorStatus.RXEP == 1)
  {
    returnValue = 1;
  }
  
  return (returnValue);
}

/* Tx Passive Error 상태인지 체크 */
uint8_t CANSPI_isTxErrorPassive(void)
{
  uint8_t returnValue = 0;
  
  errorStatus.error_flag_reg = MCP2515_ReadByte(MCP2515_EFLG);
  
  if(errorStatus.TXEP == 1)
  {
    returnValue = 1;
  }
  
  return (returnValue);
}

/* Register 저장값을 Extended ID 타입으로 변환하기 위한 함수 */
static uint32_t convertReg2ExtendedCANid(uint8_t tempRXBn_EIDH, uint8_t tempRXBn_EIDL, uint8_t tempRXBn_SIDH, uint8_t tempRXBn_SIDL) 
{
  uint32_t returnValue = 0;
  uint32_t ConvertedID = 0;
  uint8_t CAN_standardLo_ID_lo2bits;
  uint8_t CAN_standardLo_ID_hi3bits;
  
  CAN_standardLo_ID_lo2bits = (tempRXBn_SIDL & 0x03);
  CAN_standardLo_ID_hi3bits = (tempRXBn_SIDL >> 5);
  ConvertedID = (tempRXBn_SIDH << 3);
  ConvertedID = ConvertedID + CAN_standardLo_ID_hi3bits;
  ConvertedID = (ConvertedID << 2);
  ConvertedID = ConvertedID + CAN_standardLo_ID_lo2bits;
  ConvertedID = (ConvertedID << 8);
  ConvertedID = ConvertedID + tempRXBn_EIDH;
  ConvertedID = (ConvertedID << 8);
  ConvertedID = ConvertedID + tempRXBn_EIDL;
  returnValue = ConvertedID;    
  return (returnValue);
}

/* Register 저장값을 Standard ID 타입으로 변환하기 위한 함수 */
static uint32_t convertReg2StandardCANid(uint8_t tempRXBn_SIDH, uint8_t tempRXBn_SIDL) 
{
  uint32_t returnValue = 0;
  uint32_t ConvertedID;
  
  ConvertedID = (tempRXBn_SIDH << 3);
  ConvertedID = ConvertedID + (tempRXBn_SIDL >> 5);
  returnValue = ConvertedID;
  
  return (returnValue);
}

/* CAN ID를 Register에 저장하기 위한 변환 함수 */
static void convertCANid2Reg(uint32_t tempPassedInID, uint8_t canIdType, id_reg_t *passedIdReg) 
{
  uint8_t wipSIDL = 0;
  
  if (canIdType == dEXTENDED_CAN_MSG_ID_2_0B) 
  {
    //EID0
    passedIdReg->tempEID0 = 0xFF & tempPassedInID;
    tempPassedInID = tempPassedInID >> 8;
    
    //EID8
    passedIdReg->tempEID8 = 0xFF & tempPassedInID;
    tempPassedInID = tempPassedInID >> 8;
    
    //SIDL
    wipSIDL = 0x03 & tempPassedInID;
    tempPassedInID = tempPassedInID << 3;
    wipSIDL = (0xE0 & tempPassedInID) + wipSIDL;
    wipSIDL = wipSIDL + 0x08;
    passedIdReg->tempSIDL = 0xEB & wipSIDL;
    
    //SIDH
    tempPassedInID = tempPassedInID >> 8;
    passedIdReg->tempSIDH = 0xFF & tempPassedInID;
  } 
  else
  {
    passedIdReg->tempEID8 = 0;
    passedIdReg->tempEID0 = 0;
    tempPassedInID = tempPassedInID << 5;
    passedIdReg->tempSIDL = 0xFF & tempPassedInID;
    tempPassedInID = tempPassedInID >> 8;
    passedIdReg->tempSIDH = 0xFF & tempPassedInID;
  }
}
