OpenSourceEBike/EV_Display_Bluetooth_Ant/(commit log)

2021-10-22 Display almost works 100%
    [Ebike_wireless_bootloader.sch, TSDZ2_wireless_box.FCStd, TSDZ2_wireless_box.amf, TSDZ2_wireless_box_cover.FCStd, TSDZ2_wireless_box_cover.amf, TSDZ2_wireless_small_box.FCStd, TSDZ2_wireless_small_box.amf, TSDZ2_wireless_small_box_cover.FCStd]
2021-10-26 WIP display and buttons work
    [schematic.sch]
2021-10-26 Added power off
2021-10-26 Corrected issue on power off
    [main.c]
2021-10-29 Customized fields are now saved. Motor controller turn on/off now works
    [Ebike_wireless_bootloader.sch, TSDZ2_wireless_box.FCStd, TSDZ2_wireless_box.amf, TSDZ2_wireless_box_cover.FCStd, TSDZ2_wireless_box_cover.amf, Wireless_eBike.sch, stlink-v2.cfg]
2021-10-29 Folder rename from TSDZ2 to display
    [TSDZ2_wireless_box.FCStd, TSDZ2_wireless_box.amf, TSDZ2_wireless_box_cover.FCStd, TSDZ2_wireless_box_cover.amf, TSDZ2_wireless_small_box.FCStd, TSDZ2_wireless_small_box.amf, TSDZ2_wireless_small_box_cover.FCStd, TSDZ2_wireless_small_box_cover.amf]
2021-10-31 Changed bootloader to start only with the long press of the 3 buttons
    [Ebike_wireless_bootloader.sch, stlink-v2.cfg]
2021-11-01 Changed screen rotation, needed for the latest prototype
2021-11-04 Added ifdef switch to alternate between displays
2021-11-06 Corrected battery symbol issue. Increased battery SOC font
    [Ebike_wireless_bootloader.sch, stlink-v2.cfg]
2021-11-06 Increased a bit and centered battery icon
2021-11-09 Changed bootloader to be only UP and DOWN buttons
2021-11-10 Corrected motor power
2021-11-10 Corrected battery symbol
2021-11-13 Inverted display for latest prototype
    [display.c]
2021-11-13 Corrected the schematic
    [schematic.sch]
2021-11-15 Corrected calc wh. Added Used wh and remain wh fields
    [eeprom.h, mainscreen.c, state.c, state.h]
2021-11-17 Corrected issue with battery resistance not being stored
    [eeprom.c, main.c, main.h, screen.c]
2021-11-23 Updated 3D printed enclosure on the screws hole dimensions
    [display_base.FCStd, display_base.amf, display_cover.FCStd, display_cover.amf]
2021-11-26 Updated 3D printed enclosure or the correct srews size. Updated schematic PNG file
    [display_base.FCStd, display_base.amf, display_cover.FCStd, display_cover.amf]
2021-11-26 WIP SPI display version
    [display_base.FCStd, display_base.amf, display_cover.FCStd, display_cover.amf]
2021-11-27 SPI display works
2021-11-27 Enabled auto power off and configs reset to defaults
    [eeprom.c, mainscreen.c, state.c]
2021-11-28 Added schematic version for display SPI and I2C
    [Wired_remote.sch, schematic-OLED_I2C.sch, schematic-OLED_SPI.sch, schematic.sch]
2021-12-05 Updated schematic on missing GND for buttons
    [schematic-OLED_I2C.sch, schematic-OLED_SPI.sch]
2021-12-13 Corrected issue with assist levels not working over number 8
    [eeprom.c, eeprom.h, main.h]
2021-12-13 Updated schematic, OLED Vcc now connects to 5V do the display is more bright at outdoors
    [schematic-OLED_I2C.sch, schematic-OLED_SPI.sch]
2021-12-13 Added I2C PNG schematic
2022-03-25 Added Bafang M500 M600 schematic
    [schematic-OLED_I2C.sch, schematic-OLED_SPI-Bafang_M500_M600.kicad_sch, schematic-OLED_SPI-Bafang_M500_M600.sch, schematic-OLED_SPI.sch, schematic.sch]
2022-04-16 Added Bafang M500/M600 support on hardware and firmware
    [jlink.cfg, nrf52.cfg, schematic-OLED_SPI-Bafang_M500_M600.kicad_sch, stlink.cfg]
2022-04-22 Fixed 2-pixel offset on 1.3 inch SPI display (SH1106)
2022-05-05 Updated firmware for Bafang version, now on_off button works. Updated the schematic based on current prototype
    [schematic-OLED_SPI-Bafang_M500_M600.kicad_sch]
2022-05-05 Corrected issue with bootloader
    [main.c, mainscreen.c]
2022-05-06 Set max wheel speed works
2022-05-06 Implemented assist level. Corrected issue with set max wheel speed
    [can.c, configscreen.c]
2022-05-09 Updated the schematic - walk assist works. Updated the firmware for latest hardware
    [schematic-OLED_SPI-Bafang_M500_M600.kicad_sch]
2022-05-09 Added brake state
2022-05-23 Added invert display and invert buttons configurations
    [configscreen.c, display.c, eeprom.c, eeprom.h, main.c, mainscreen.c, state.c, state.h]
2022-06-15 ANT+ CONTROLS works for Garmin Edge page change. Corrected wheel speed sent to ANT+ LEV
    [buttons.c, buttons.h, main.c, screen.h]
2022-08-10 esc_temp & 3 wheel parameters done
    changed programmer from ST-Link to CMSIS-DAP
    [jlink.cfg]
2022-11-24 Added schematic for VESC version. Added also local files that should be added before, like the 3D printed enclosure
    [assembly.FCStd, base.FCStd, cover.FCStd, round.FCStd, schematic-OLED_SPI-VESC.kicad_sch]
