OpenSourceEBike/EV_Display_Bluetooth_Ant/(notices)

Notices in the files:
firmware/display/screen.c:
(MIT License)
